belivablelevi/Lumi/README.md

# Lumi

**An open-source, build-it-yourself robot keychain pet.** A tiny glowing face
that feels your pats and shakes, has moods, sleeps when you put it down,
wakes when you pick it up, and plays ping-pong with a friend's
Lumi over the air.

Lumi is an independent DIY recreation of the *kind* of gadget popularised by
the Rekko NEO keychain. It's built from ~$15 of off-the-shelf modules. It
shares no code, artwork or branding with Rekko and isn't affiliated with it.

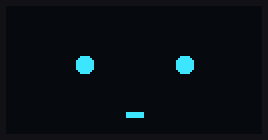
[picture p1: docs/previews/highlights.gif]
highlights


| Spec card item | Lumi |
|---|---|
| 0.96" OLED, 128×64, glowing cyan | SSD1306 0.96" 128×64 (blue panel reads as cyan) |
| Motion sensor, 6-axis, feels every pat & shake | MPU-6050: pat, double-pat, pat-spam, shake, drop, tilt, flip, pick-up, put-down |
| ESP32-C3 brain, runs 60+ animations | XIAO ESP32C3 · **64 animations** from 29 parametric expressions, plus blinking, eye-darts and breathing on top |
| 2-player wireless battle | **Tilt Pong** over ESP-NOW: classic Pong across two screens. Tilt to move your paddle, pat to smash, first to 5 |
| Battery inside | 702025 300 mAh LiPo (the case can be resized for others) |
| USB-C rechargeable | XIAO's USB-C + on-board charger |
| Deep-sleeps when idle | ESP32-C3 deep sleep, display off, IMU on wake-on-motion |
| Wakes when you pick it up | MPU-6050 motion interrupt → GPIO3 deep-sleep wake |
| Free animation updates | Wi-Fi update mode: phone → `192.168.4.1` → upload |
| 35 × 37 mm glitter shell | Parametric OpenSCAD snap-fit case, 35 × 37 × 25.5 mm, print in glitter PLA |

## What it looks like

All 29 expressions (rendered by the real firmware code in the simulator):

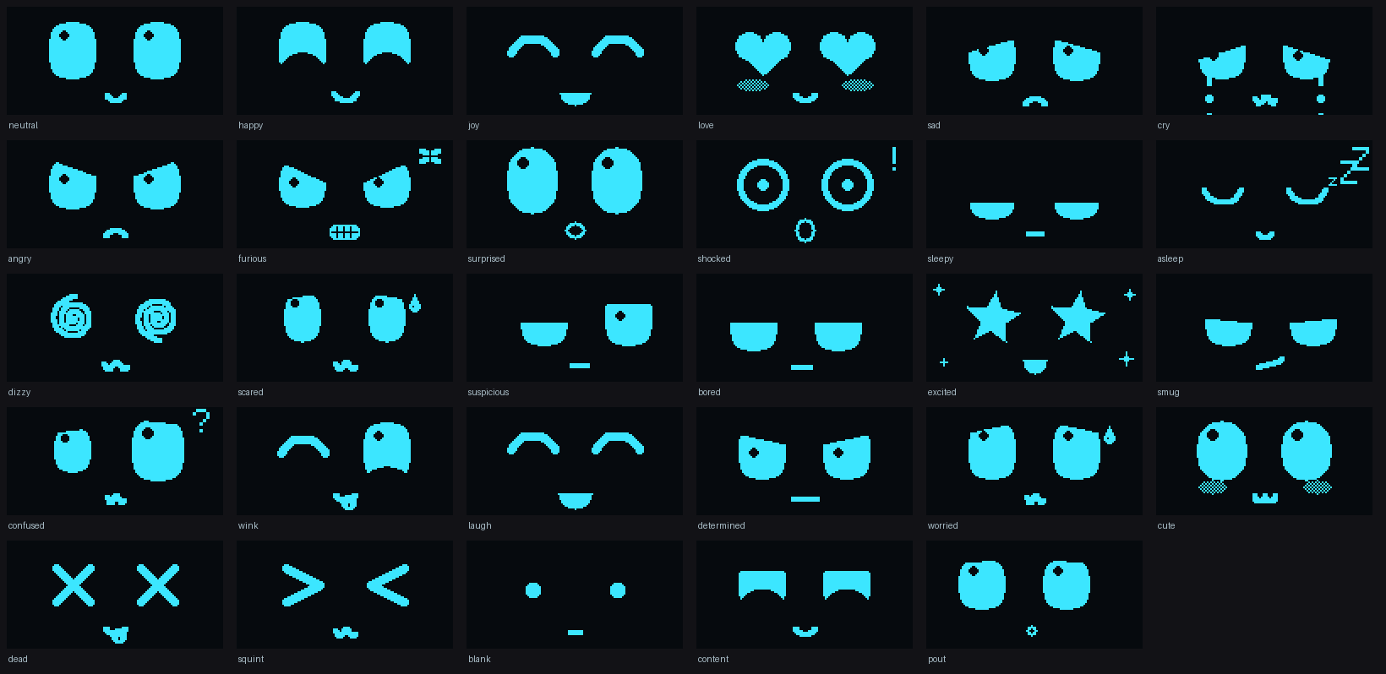
[picture p2: docs/previews/expressions.png]
expressions


Menu, battery, update and Tilt Pong screens:

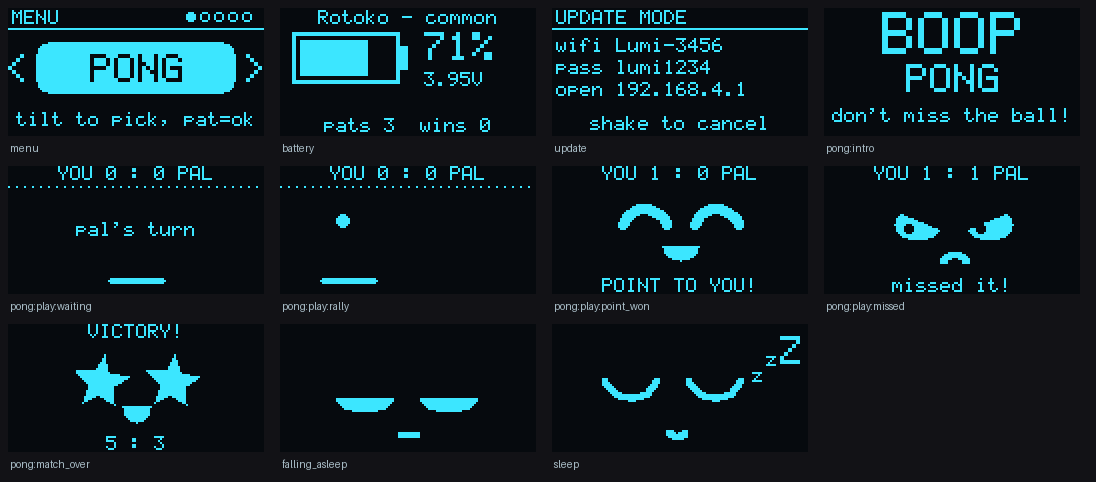
[picture p3: docs/previews/screens.png]
screens


A scripted session: boot, pats, shake, menu, a full Tilt Pong match, falling asleep
([tour.gif](docs/previews/tour.gif)).

## Every Lumi is one of a kind

Each unit has its own eyes, highlight, accent and temperament: 108,000
combinations, with common, uncommon, rare and legendary units. A unit gets
its personality automatically from its chip ID. Makers can also assign
one at the factory with **Lumi Studio**, a desktop app (Windows, macOS,
Linux) for:

- designing new faces and animations,
- generating batches of unique units with a rarity mix you choose,
- writing each unit's persona over USB and recording it in a manifest.

See [docs/studio.md](docs/studio.md).

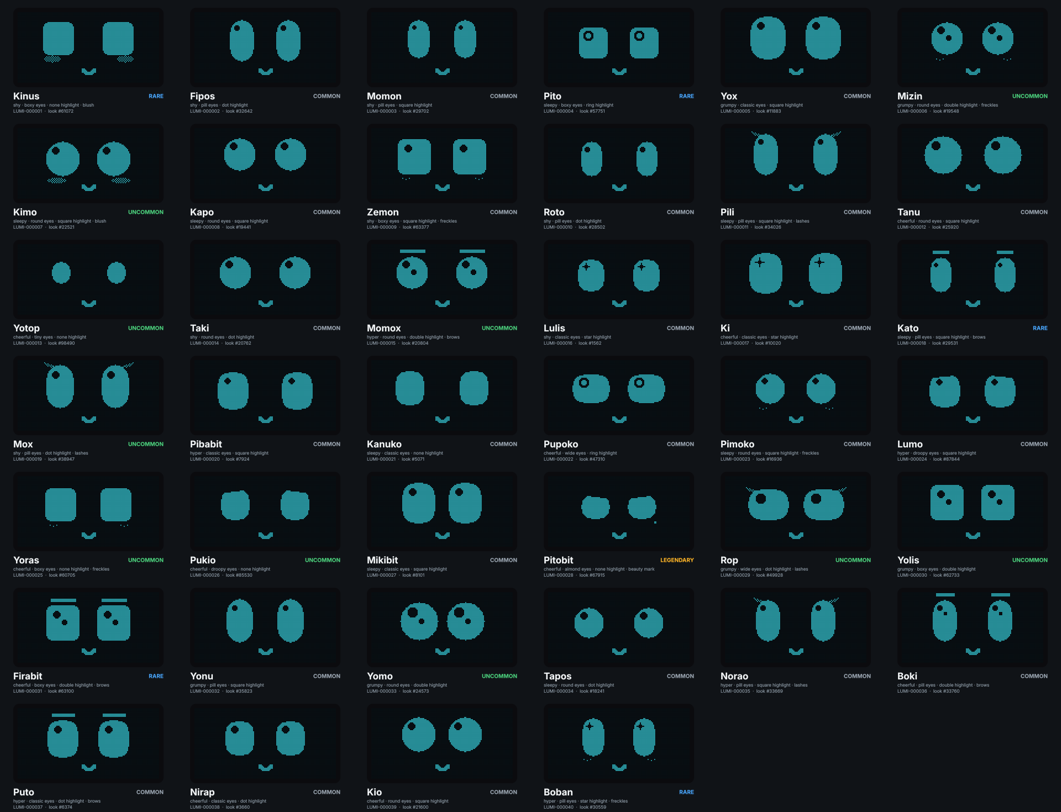
[picture p4: docs/previews/studio/cards-sheet.png]
units


## The website

`web/` is the Snaggo storefront for Lumi, at [snaggo.tech](https://snaggo.tech). It's a Next.js site with pre-orders through Stripe, launch emails, and the
firmware's real animations playing on every screen. See [web/README.md](web/README.md).

## Repository layout

```
firmware/
  platformio.ini            PlatformIO project (XIAO ESP32C3)
  src/                      hardware glue: main.cpp, OLED + IMU drivers, config.h (pins & tuning)
  lib/lumi_core/src/        portable brain, no Arduino dependencies:
    face.*                    parametric face renderer + 29 expressions
    animations.*              64 animations (data tables; add your own here or in Lumi Studio)
    genes.*                   per-unit looks, temperament and rarity
    pack.*                    emotion packs: custom faces, animations and a persona
    serial_cmd.*              USB provisioning protocol
    animator.*                tweening, blinking, eye darts, motion layers
    gestures.*                pat / shake / tilt / pickup / freefall detection
    mood.h                    happiness + energy, persisted across deep sleep
    pong.*                    Tilt Pong: pairing, ball hand-off over the radio, scoring
    app.*                     behaviour: modes, menu, sleep rules, screens
    gfx.*                     1-bit framebuffer + 5x7 font
hardware/
  BOM.md · wiring.md
  enclosure/lumi_case.scad  parametric case; stl/ has ready-to-print parts
docs/
  using-lumi.md             gestures, mood, menu, Tilt Pong, OTA, serial console
  assembly.md               build guide + first-power-up checklist
  studio.md                 Lumi Studio guide for makers
  previews/                 rendered images
tests/                      desktop tests for the core (make -C tests)
tools/
  sim/                      desktop simulator → PNG/GIF previews
  studio/                   Lumi Studio desktop app (PySide6) + liblumicore C API + virtual Lumi
web/                        the Snaggo website (Next.js storefront, pre-orders, launch signups)
  arduino_build.sh          build with arduino-cli / Arduino IDE instead of PlatformIO
```

## Build the firmware

**PlatformIO** (recommended):

```sh
cd firmware
pio run -t upload        # build + flash over USB-C
pio device monitor       # serial console (type 'h' for commands)
```

**arduino-cli / Arduino IDE** (ESP32 core 2.0.17):

```sh
tools/arduino_build.sh                # compile
tools/arduino_build.sh /dev/ttyACM0   # compile + upload
```

Using an **ESP32-S3 SuperMini** instead of the XIAO? Build with
`pio run -e esp32s3_supermini -t upload`, and see the S3 section of
[`hardware/wiring.md`](hardware/wiring.md#alternative-esp32-s3-supermini) for its
pins, power options and the matching case setting.

If the XIAO doesn't show up as a serial port, hold **BOOT**, tap **RESET**,
release **BOOT**, then upload again.

## Hack on it without hardware

The behaviour runs on your computer exactly as it does on the device:

```sh
make -C tests                         # 819 checks: gestures, pong, animations, genes, packs, app flows
python3 tools/sim/make_previews.py    # re-render docs/previews (needs Pillow)
python3 tools/sim/make_previews.py --all-gifs   # one GIF per animation in build/sim/gifs
```

Adding an animation is a few lines in `firmware/lib/lumi_core/src/animations.cpp`:
a list of `(expression, gaze, motion, tween ms, hold ms, effects)` keys
plus a table row saying which gesture triggers it and in which mood range.

## How it works (short version)

- **Face**: a face is ~20 numbers (eye size, lids, slant, cheeks, gaze, mouth
  shape…). Expressions are presets, and animations tween between them.
  Blinks, eye darts and breathing are layered on top, so Lumi never looks
  frozen.
- **Gestures**: the MPU-6050 samples at 100 Hz into its FIFO. The firmware
  high-passes the signal. Short sharp bursts are pats, repeated big bursts
  are shakes. Low-passed gravity gives orientation; |a| ≈ 0 is free-fall.
  Tap timestamps come from the FIFO cadence, so they stay accurate even
  while the display is being redrawn.
- **Tilt Pong**: ESP-NOW broadcast, no pairing. The Lumi with the higher
  MAC hosts and serves first. Tilt steers the paddle (low-passed gravity
  X). Only the Lumi the ball is on decides whether it was hit, so radio latency just makes the flight a little longer. Each
  ball crossing the net carries a sequence number plus its position, angle
  and speed, and each Lumi's miss count only ever grows. Packets repeat
  ~10 times a second, so lost ones only add delay. The tests play whole
  matches, and 90-second rallies, over a simulated link with 40% packet loss.
- **Sleep**: display charge pump off, IMU to low-power cycle mode with a
  latched motion interrupt on GPIO3, ESP32-C3 into deep sleep. Mood lives
  in RTC memory, and the RTC clock tells Lumi how long it slept.

## Status

- ✅ Core logic: 819 automated checks pass (ASan/UBSan clean), including
  two simulated Lumis playing complete Tilt Pong matches through their menus.
- ✅ Lumi Studio: 13 tests drive every tab offscreen and provision a virtual
  Lumi end to end. The packaged Linux app was built and started here. CI
  builds Windows and macOS too, but they haven't been tried by a person yet.
- ✅ Firmware compiles and links for the ESP32-C3 and ESP32-S3 (Arduino core
  2.0.17, `-Wall -Wextra`, no warnings in Lumi's code). On the C3 it uses
  812 KB of flash (63% of an OTA slot) and 87 KB of RAM.
- ✅ Case renders to valid STLs at 35 × 37 mm.
- ⚠️ **Not yet tested on real hardware.** Expect to tune the IMU axis map,
  tap threshold and wake sensitivity once it's built (see the checklist in
  `docs/assembly.md`), and to adjust case tolerances after a test print.
- ⚠️ The case is 25.5 mm deep because a stock GY-521 board won't fit beside
  the XIAO. A custom PCB, or a smaller IMU breakout, could get it thinner.

## License

MIT, see [LICENSE](LICENSE).
