belivablelevi/Lumi/hardware/filament.md

# Filament

## Test rolls

| Supplier | Order | Price (CAD) | Checked |
|---|---|---|---|
| [ELEGOO on Amazon.ca](https://www.amazon.ca/dp/B0DWJRNJTD) | 1 black and 1 grey PETG, 1.75 mm, 1 kg each (2-pack) | $33.29 (deal price, before tax) | November 2026 |

Use these to test case fit and the snap hooks in each colour. Buy more only after a case passes. Grey is the planned shell colour.

Print settings (Neptune 3 Pro, brass nozzle): 235-245 °C nozzle, 70-80 °C bed, 30-50% fan so the hook layers bond, glue stick or textured PEI. Dry the roll if it strings.

Plain PETG only. Carbon-fibre PETG is stiffer and more brittle, so the snap hooks are more likely to crack, and it wears out a brass nozzle.

## Compared

Filaments.ca: 1 black and 1 white Select PETG, 1 kg each, came to $45.18 ($29.98 + $10 shipping + tax).

Alibaba (Shenzhen Zhengtai Technology Co., Ltd.): the same two colours came to $53.69 CAD before tax ($11.86 rolls + $41.84 shipping), with delivery on Nov 17 at the earliest. Keep it as a possible sample order if a cheaper production supplier is needed later.
