belivablelevi/Lumi/hardware/pcb/BUDGET.md

# Lumi PCB v1: budget

Generated by [`budget.py`](budget.py) from prices checked on **2026-10-30**,
at **1 USD = 1.40 CAD**.

Prices move. Before you order:
- recheck everything against the JLCPCB quote page and LCSC,
- refresh lines marked *est.*, which come from similar listings rather than a live quote.

Edit the tables in `budget.py` and re-run it to update this page.

## At a glance

| | USD | CAD |
|---|--:|--:|
| 5 prototypes, all in | $190.02 | $266.03 |
| … per prototype | $38.00 | $53.21 |
| 10 prototypes, all in | $265.16 | $371.22 |
| … per prototype | $26.52 | $37.12 |
| One Lumi at 100 units | $11.22 | $15.70 |
| One Lumi at 1,000 units | $7.95 | $11.13 |
| **Average unit cost at 100 units** (packed, fees, spares, prototypes) | – | **$23.56** |
| **Average unit cost at 1,000 units** (packed, fees, spares, prototypes) | – | **$14.74** |

The device figures include:
- the board, built by JLCPCB,
- the screen, battery and printed case,
- shipping to Canada, GST and courier brokerage.

The average unit cost adds packaging, spares, the Stripe fee and the prototype run (see below).
Neither includes certification (until you enter a lab quote), customs duty beyond GST, or your time.

## 5 prototypes

| Item | USD | CAD |
|---|--:|--:|
| Board parts | $22.10 | $30.94 |
| Assembly (solder joints) | $2.01 | $2.82 |
| Bare boards (order of 5) | $4.00 | $5.60 |
| Assembly setup, stencil, 10 Extended-part fees | $43.00 | $60.20 |
| Screens | $12.45 | $17.43 |
| Batteries | $30.00 | $42.00 |
| Cases (printed) and sundries | $3.00 | $4.20 |
| Shipping: JLCPCB boards (DHL) | $25.00 | $35.00 |
| Shipping: Screens from BuyDisplay | $15.00 | $21.00 |
| Shipping: Batteries (AliExpress, ground) | $4.00 | $5.60 |
| GST 5% on imports | $8.03 | $11.24 |
| Courier brokerage (2 parcels) | $21.43 | $30.00 |
| **Total** | **$190.02** | **$266.03** |

## 10 prototypes

| Item | USD | CAD |
|---|--:|--:|
| Board parts | $44.20 | $61.88 |
| Assembly (solder joints) | $4.02 | $5.63 |
| Bare boards (order of 10) | $6.00 | $8.40 |
| Assembly setup, stencil, 10 Extended-part fees | $43.00 | $60.20 |
| Screens | $24.90 | $34.86 |
| Batteries | $60.00 | $84.00 |
| Cases (printed) and sundries | $6.00 | $8.40 |
| Shipping: JLCPCB boards (DHL) | $25.00 | $35.00 |
| Shipping: Screens from BuyDisplay | $15.00 | $21.00 |
| Shipping: Batteries (AliExpress, ground) | $4.00 | $5.60 |
| GST 5% on imports | $11.61 | $16.25 |
| Courier brokerage (2 parcels) | $21.43 | $30.00 |
| **Total** | **$265.16** | **$371.22** |

Notes on the prototype runs:
- **Fixed costs dominate:**
  - JLCPCB's setup, stencil and the 10 Extended-part fees ($3.00 each) come to $43.00 however many boards you build,
  - so does shipping.
  - That's why 10 boards cost far less than twice 5.
- **Extended-part fee:** one source says it dropped to $1.50 per part in December 2025. If your quote shows that, the run is about $12 cheaper.
- **Batteries:** buy them separately, by ground shipping. JLCPCB doesn't send lithium cells by air with boards.
- **Taxes:** courier parcels from China are taxed above CAD 20. HST provinces pay 13–15% instead of the 5% GST used here.

## Per Lumi at 100 units

| Item | USD | CAD |
|---|--:|--:|
| Board parts | $3.55 | $4.97 |
| Bare board | $0.25 | $0.35 |
| Assembly (joints) | $0.40 | $0.56 |
| Assembly setup and fees, shared | $0.60 | $0.84 |
| Screen | $2.23 | $3.12 |
| Battery | $2.50 | $3.50 |
| Case and sundries | $0.55 | $0.77 |
| Shipping share | $0.60 | $0.84 |
| GST 5% on imports | $0.53 | $0.75 |
| **Per unit** | **$11.22** | **$15.70** |

## Per Lumi at 1,000 units

| Item | USD | CAD |
|---|--:|--:|
| Board parts | $3.22 | $4.51 |
| Bare board | $0.08 | $0.11 |
| Assembly (joints) | $0.40 | $0.56 |
| Assembly setup and fees, shared | $0.06 | $0.08 |
| Screen | $1.70 | $2.38 |
| Battery | $1.40 | $1.96 |
| Case and sundries | $0.51 | $0.71 |
| Shipping share | $0.20 | $0.28 |
| GST 5% on imports | $0.38 | $0.53 |
| **Per unit** | **$7.95** | **$11.13** |

Notes on volume:
- **Setup:** assembly switches to Standard PCBA ($25 setup), shared across the run.
- **Biggest items:** the module and the screen are the two largest costs.
- **Screen:** at 1,000 the screen is an estimate for a factory-direct quote (the listing stops at $2.23 for 100).
- **Battery:** the 1,000 price assumes a factory quote with UN38.3 reports.
- **Case:** a home-printed case is cheap in plastic (~$0.45) but takes about 2.5 hours of printer time each. At 1,000, a print farm or an injection mould changes this line.

## Average unit cost (CAD)

From the device cost above to what each Lumi really costs: packed, with spares, the Stripe fee and the
prototype run spread over the batch. Packaging prices are estimates; edit `PACKAGING_CAD` (or the
**Full unit cost** tab in the workbook) with real quotes.

| Item | 100 units | 1,000 units |
|---|--:|--:|
| Device: board, screen, battery, case, import shipping, GST | $15.70 | $11.13 |
| Mailer box, 3 x 3 x 2 in | $0.60 | $0.35 |
| Padding (crinkle paper or foam) | $0.10 | $0.05 |
| Birth certificate (1/8 Letter sheet of card stock + ink) | $0.15 | $0.10 |
| Odds card (printed 4 x 6 postcard) | $0.40 | $0.12 |
| Shipping label | $0.10 | $0.05 |
| Spares and failed units (5% of the device) | $0.79 | $0.56 |
| **Cost to make and pack** | **$17.84** | **$12.36** |
| Stripe fee at a $59.00 price | $2.01 | $2.01 |
| Prototype run (10 boards) spread over the run | $3.71 | $0.37 |
| Certification (lab quote) spread over the run | $0.00 | $0.00 |
| One-time tools spread over the run | $0.00 | $0.00 |
| **Average unit cost** | **$23.56** | **$14.74** |
| Left from a $59.00 sale | $35.44 (60%) | $44.26 (75%) |

Notes:
- **Shipping** isn't here: the customer pays it at checkout. Stripe's fee on the shipping part (2.9%) is left out too.
- **Certification** is the big unknown: EMC testing of the finished Lumi (the radio module is already certified) often costs thousands. $2,000 adds $20 a unit at 100 and $2 at 1,000. Enter your lab quote in `CERT_CAD`.
- **Your time** (assembly, provisioning, testing, packing: maybe 10–15 minutes a unit) and **printer time** (about 2.5 h a case) aren't counted.
- The **price** ($59.00) is only an example, used for the Stripe fee and the margin line.

## Board parts by quantity (USD each)

| Ref | Part | LCSC | 5–10 boards | 100 | 1,000 |
|---|---|---|--:|--:|--:|
| U1 | ESP32-C3-MINI-1-H4X module | C41349510 | $2.72 | $2.26 | $2.16 |
| U2 | LIS2DH12TR accelerometer | C110926 | $0.78 | $0.58 | $0.53 |
| J2 | JUSHUO AFC07-S30ECC-00 screen connector | C11095 | $0.15 | $0.12 | $0.09 |
| D1 | USBLC6-2SC6 USB ESD | C7519 | $0.18 | $0.14 | $0.10 |
| J1 | USB-C receptacle TYPE-C-31-M-12 | C165948 | $0.19 | $0.15 | $0.10 |
| U4 | RT9080-33GJ5 3.3 V regulator | C841192 | $0.12 | $0.10 | $0.08 |
| U3 | TP4054 charger | C32574 | $0.13 | $0.10 | $0.08 |
| SW1 | MSK12C02 slide switch | C431540 | $0.05 | $0.04 | $0.04 |
| R/C | 28 resistors and capacitors (Basic except R8, R15) *est.* | various | $0.10 | $0.06 | $0.04 |

Board part prices are JLCPCB's parts library on 2026-11-05 (the 10, 100 and 1,000 price breaks).

> **Stock warning (2026-11-04):** JLCPCB and LCSC have **0** LIS2DH12TR (C110926) in stock. Before ordering boards, either wait for a restock, buy them elsewhere and send them to JLCPCB as consigned parts, or switch to an in-stock part with the same 2 × 2 mm LGA-12 package, such as the LIS2DW12TR (C189624, about $0.68 at 100). The LIS2DW12 has a different register map, so the firmware's accelerometer driver and the schematic would need checking first.
| Screen | BuyDisplay ER-OLED0.96-1 plug-in OLED (1,000: est. factory quote) | – | $2.49 | $2.23 | $1.70 |
| Battery | 503030 LiPo ~500 mAh, protected, UN38.3 (est.) | – | $6.00 | $2.50 | $1.40 |
| Case | Mini Lumi PCB case, PLA, ~17 g at $25/kg (your printer; ~2.5 h) | – | $0.45 | $0.45 | $0.45 |
| Sundries | foam tape, Kapton, battery wire (est.) | – | $0.15 | $0.10 | $0.06 |

## Sources

- [JLCPCB: what the PCB assembly price includes](https://jlcpcb.com/help/article/pcb-assembly-price)
- [JLCPCB PCBA price overview (feeder fee change)](https://techoverflow.net/2024/04/09/jlcpcb-pcba-assembly-price-overview/)
- [JLCPCB $2 PCB offer](https://jlcpcb.com/blog/free-assembly-for-1-6-layer-pcbs-and-discounts-on-8-20-layer-pcba)
- [ESP32-C3-MINI-1-H4X on JLCPCB](https://jlcpcb.com/partdetail/ESP32-C3-MINI-1-H4X/C41349510)
- [LIS2DH12TR on LCSC](https://www.lcsc.com/product-image/C110926.html)
- [TYPE-C-31-M-12 on LCSC](https://lcsc.com/product-detail/USB-Connectors_Korean-Hroparts-Elec-TYPE-C-31-M-12_C165948.html)
- [JUSHUO AFC07-S30ECC-00 on JLCPCB](https://jlcpcb.com/partdetail/C11095)
- [USBLC6-2SC6 on JLCPCB](https://jlcpcb.com/partdetail/C7519)
- [BuyDisplay ER-OLED0.96-1](https://buydisplay.com/blue-128x64-0-96-inch-oled-display-top-contact-connector-fpc-ssd1306)
- [503030 500 mAh protected LiPo (retail reference)](https://www.walmart.com/ip/seot/5362991161)
- [Shipping and brokerage to Canada (forum reports)](https://forum.kicad.info/t/alternatives-to-jlcpcb-or-pcbway-for-canadian-hobbyist/61624)
- [CBSA: courier imports from outside the US/Mexico (CAD 20 threshold)](https://www.cbsa-asfc.gc.ca/services/cusma-aceum/lvs-efv-eng.html)
- [USD/CAD, October 2026](https://moneyexchangerate.org/currencyexchange/usd/cad)
- [Stripe pricing, Canada](https://stripe.com/en-ca/pricing)
