belivablelevi/Lumi/docs/previews/tour.gif

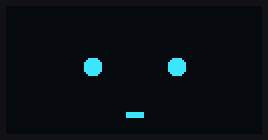
docs/previews/tour.gif
