belivablelevi/Lumi/hardware/pcb/kicad/renders/schematic.png

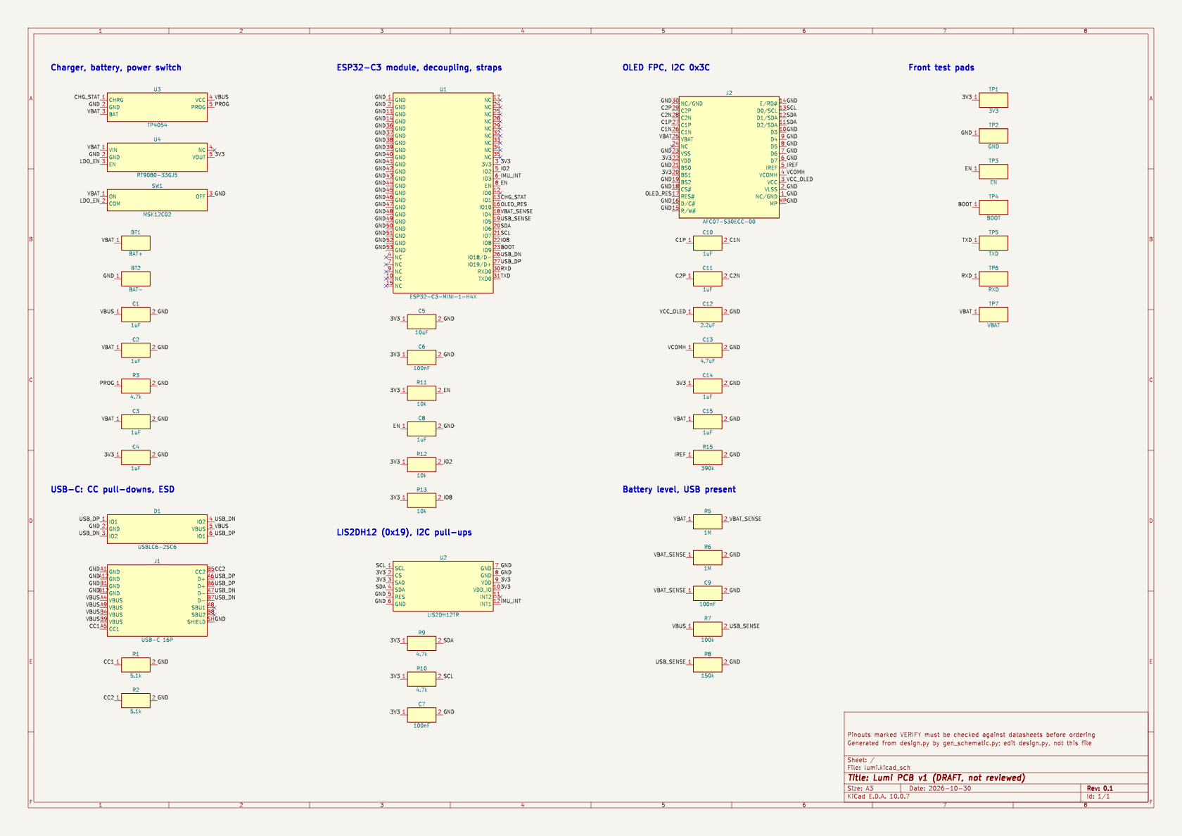
hardware/pcb/kicad/renders/schematic.png
