belivablelevi/Lumi/hardware/pcb/kicad/fab/parts-check.txt

Lumi PCB parts check, 2026-11-06
Generated by hardware/pcb/kicad/verify_parts.py against JLCPCB's parts library and LCSC's footprints. FIX = must change before ordering; note = worth knowing.

U1  ESP32-C3-MINI-1-H4X  C41349510  (lumi:ESP32-C3-MINI-1)
  ESP32-C3-MINI-1-H4X: Extended, JLCPCB stock 689, $3.1072 each
  -104dBm -40℃~+105℃ 2.4GHz 20.5dBm 350mA 3V~3.6V 82mA ESP32-C3FH4 Integrated Bluetooth function On-board PCB Antenna UART、SPI、I2C、GPIO、I2S、USB SMD,16.6x13.2mm WiFi Modules
  footprint: 61 pads line up (worst 0.000 mm) with LCSC's turned 0 degrees
  pins: names match LCSC's symbol

U2  LIS2DH12TR  C110926  (Package_LGA:LGA-12_2x2mm_P0.5mm)
  LIS2DH12TR: Extended, JLCPCB stock 9728, $0.9250 each
  -40℃~+85℃ 0.2KB 1.71V~3.6V 500nA 8bit、10bit、12bit Accelerometer Motion event detection SPI、I2C X,Y,Z ±16g LGA-12(2x2) Accelerometers
  footprint: 12 pads line up (worst 0.113 mm) with LCSC's turned 90 degrees
  pins: names match LCSC's symbol
  note: reviewed: KiCad's LGA-12 pads sit 0.11 mm further under the part than LCSC's. Both patterns are the same size and both overlap the LIS2DH12's 2 x 2 mm lands, so either solders; KiCad's stays inside the package outline. (12 pad differences)
  note: LCSC's footprint is turned 90 degrees from ours: JLCPCB's placement preview may show this part turned; turn it back to match the silkscreen

U3  TP4054  C32574  (Package_TO_SOT_SMD:SOT-23-5)
  TP4054-42-SOT25R: Extended, JLCPCB stock 74428, $0.1322 each
  -40℃~+85℃ 1 4.2V 450mA 45uA 4V~9V Charging IC Lithium Battery Not supported Not supported SOT-23-5 Battery Management
  footprint: 5 pads line up (worst 0.019 mm) with LCSC's turned 90 degrees
  pins: names match LCSC's symbol
  note: pad 1 is 1.32 x 0.60 mm, LCSC's 1.16 x 0.49
  note: pad 2 is 1.32 x 0.60 mm, LCSC's 1.16 x 0.49
  note: pad 3 is 1.32 x 0.60 mm, LCSC's 1.16 x 0.49
  note: LCSC's footprint is turned 90 degrees from ours: JLCPCB's placement preview may show this part turned; turn it back to match the silkscreen

U4  RT9080-33GJ5  C841192  (Package_TO_SOT_SMD:SOT-23-5)
  RT9080-33GJ5: Extended, JLCPCB stock 23633, $0.1197 each
  -40℃~+125℃@(Tj) 1 2uA 3.3V 360mV@(600mA) 42uVrms 5.5V 600mA 75dB@(1kHz) Fixed Over Current Protection、Over Temperature Protection、Enable Positive TSOT-23-5 Voltage Regulators - Linear, Low Drop Out (LDO) Regulators
  footprint: 5 pads line up (worst 0.012 mm) with LCSC's turned 90 degrees
  pins: names match LCSC's symbol
  note: pad 1 is 1.32 x 0.60 mm, LCSC's 1.05 x 0.53
  note: pad 2 is 1.32 x 0.60 mm, LCSC's 1.05 x 0.53
  note: pad 3 is 1.32 x 0.60 mm, LCSC's 1.05 x 0.53
  note: pad 4 is 1.32 x 0.60 mm, LCSC's 1.05 x 0.53
  note: pad 5 is 1.32 x 0.60 mm, LCSC's 1.05 x 0.53
  note: LCSC's footprint is turned 90 degrees from ours: JLCPCB's placement preview may show this part turned; turn it back to match the silkscreen

D1  USBLC6-2SC6  C7519  (Package_TO_SOT_SMD:SOT-23-6)
  USBLC6-2SC6: Extended, JLCPCB stock 26402, $0.1624 each
  -40℃~+125℃ 150nA 17V 2 3.5pF 5.25V 5A 6V ESD IEC 61000-4-2 Unidirectional SOT-23-6L ESD and Surge Protection (TVS/ESD)
  footprint: 6 pads line up (worst 0.012 mm) with LCSC's turned 90 degrees
  pins: LCSC's symbol has numbers only
  note: pad 1 is 1.32 x 0.60 mm, LCSC's 1.07 x 0.53
  note: pad 2 is 1.32 x 0.60 mm, LCSC's 1.07 x 0.53
  note: pad 3 is 1.32 x 0.60 mm, LCSC's 1.07 x 0.53
  note: pad 4 is 1.32 x 0.60 mm, LCSC's 1.07 x 0.53
  note: pad 5 is 1.32 x 0.60 mm, LCSC's 1.07 x 0.53
  note: pad 6 is 1.32 x 0.60 mm, LCSC's 1.07 x 0.53
  note: LCSC's footprint is turned 90 degrees from ours: JLCPCB's placement preview may show this part turned; turn it back to match the silkscreen

J1  USB-C 16P  C165948  (Connector_USB:USB_C_Receptacle_HRO_TYPE-C-31-M-12)
  TYPE-C-31-M-12: Extended, JLCPCB stock 146998, $0.1870 each
  -30℃~+80℃ 1 10,000 cycles 16P 20V 5A 7.35mm Female Surface Mount, Right Angle Type-C SMD USB Connectors
  footprint: 20 pads line up (worst 0.118 mm) with LCSC's turned 0 degrees
  pins: names match LCSC's symbol
  note: reviewed: Measured from the peg holes, KiCad's HRO footprint has the shell slots within 0.03 mm of LCSC's; its signal pads are centred 0.18 mm further out and 0.15 mm longer (1.45 vs 1.3 mm), so they still cover the leads. Its peg holes are 0.65 mm, LCSC's 0.6 mm. (6 pad differences)
  note: pad A1 is 0.06 mm from LCSC's (a slightly different land pattern)
  note: pad A4 is 0.06 mm from LCSC's (a slightly different land pattern)
  note: pad A4 is 0.60 x 1.45 mm, LCSC's 0.60 x 1.30
  note: pad A5 is 0.30 x 1.45 mm, LCSC's 0.30 x 1.30
  note: pad A6 is 0.30 x 1.45 mm, LCSC's 0.30 x 1.30
  note: pad A7 is 0.30 x 1.45 mm, LCSC's 0.30 x 1.30
  note: pad A8 is 0.30 x 1.45 mm, LCSC's 0.30 x 1.30
  note: pad A9 is 0.06 mm from LCSC's (a slightly different land pattern)
  note: pad A9 is 0.60 x 1.45 mm, LCSC's 0.60 x 1.30
  note: pad A12 is 0.06 mm from LCSC's (a slightly different land pattern)
  note: pad A12 is 0.60 x 1.45 mm, LCSC's 0.60 x 1.30
  note: pad B1 is 0.06 mm from LCSC's (a slightly different land pattern)
  note: pad B1 is 0.60 x 1.45 mm, LCSC's 0.60 x 1.30
  note: pad B4 is 0.06 mm from LCSC's (a slightly different land pattern)
  note: pad B4 is 0.60 x 1.45 mm, LCSC's 0.60 x 1.30
  note: pad B5 is 0.30 x 1.45 mm, LCSC's 0.30 x 1.30
  note: pad B6 is 0.30 x 1.45 mm, LCSC's 0.30 x 1.30
  note: pad B7 is 0.30 x 1.45 mm, LCSC's 0.30 x 1.30
  note: pad B8 is 0.30 x 1.45 mm, LCSC's 0.30 x 1.30
  note: pad B9 is 0.06 mm from LCSC's (a slightly different land pattern)
  note: pad B9 is 0.60 x 1.45 mm, LCSC's 0.60 x 1.30
  note: pad B12 is 0.06 mm from LCSC's (a slightly different land pattern)
  note: pad SH is 1.00 x 2.10 mm, LCSC's 1.20 x 2.00
  note: pad SH is 1.00 x 1.60 mm, LCSC's 1.20 x 1.80
  note: mounting/shield pads named differently (ours->LCSC): SH->4, SH->3, SH->1, SH->2
  note: origins 1.54 mm apart: JLCPCB's preview may show the part shifted by that much; nudge it onto its pads

J2  AFC07-S30ECC-00  C11095  (lumi:JUSHUO_AFC07-S30ECC-00)
  AFC07-S30ECC-00: Extended, JLCPCB stock 19465, $0.1549 each
  -25℃~+85℃ 0.3mm 0.5mm 2mm 30P 400mA 50V Phosphor bronze Slide Lock Surface Mount, Right Angle Tin Top Contact SMD,P=0.5mm,卧贴 FFC, FPC (Flat Flexible) Connector Assemblies
  footprint: 32 pads line up (worst 0.019 mm) with LCSC's turned 0 degrees
  pins: LCSC's symbol has numbers only
  note: pads numbered from the other end (our 1 = LCSC's 30); the pads themselves line up, which is what the factory places by
  note: mounting/shield pads named differently (ours->LCSC): MP->31, MP->32
  note: origins 0.45 mm apart: JLCPCB's preview may show the part shifted by that much; nudge it onto its pads

SW1  MSK12C02  C431540  (lumi:MSK12C02)
  MSK12C02: Extended, JLCPCB stock 180989, $0.0544 each
  -20℃~+70℃ 1.4mm 10000 times 12V 2.8mm 50mA 8mm SMD(SMT) Tab SPDT Surface Mount, Right Angle SMD,8x2.8mm Slide Switches
  footprint: 7 pads line up (worst 0.000 mm) with LCSC's turned 0 degrees
  pins: LCSC's symbol has numbers only

R1,R2  5.1k  C25905  (Resistor_SMD:R_0402_1005Metric)
  0402WGF5101TCE: Basic, JLCPCB stock 4687500, $0.0023 each
  -55℃~+155℃ 5.1kΩ 50V 62.5mW Thick Film Resistor ±1% ±100ppm/℃ 0402 Chip Resistor - Surface Mount
  value 5.1k matches
  footprint: 2 pads line up (worst 0.077 mm) with LCSC's turned 0 degrees
  pins: LCSC's symbol has numbers only
  note: pad 1 is 0.08 mm from LCSC's (a slightly different land pattern)
  note: pad 2 is 0.08 mm from LCSC's (a slightly different land pattern)

C1,C2,C3,C4,C8,C10,C11,C14,C15  1uF  C52923  (Capacitor_SMD:C_0402_1005Metric)
  CL05A105KA5NQNC: Basic, JLCPCB stock 11842566, $0.0058 each
  1uF 25V X5R ±10% 0402 Multilayer Ceramic Capacitors MLCC - SMD/SMT
  value 1uF matches
  footprint: 2 pads line up (worst 0.060 mm) with LCSC's turned 0 degrees
  pins: LCSC's symbol has numbers only
  note: pad 1 is 0.06 mm from LCSC's (a slightly different land pattern)
  note: pad 2 is 0.06 mm from LCSC's (a slightly different land pattern)

R3,R9,R10  4.7k  C25900  (Resistor_SMD:R_0402_1005Metric)
  0402WGF4701TCE: Basic, JLCPCB stock 16002473, $0.0017 each
  -55℃~+155℃ 4.7kΩ 50V 62.5mW Thick Film Resistor ±1% ±100ppm/℃ 0402 Chip Resistor - Surface Mount
  value 4.7k matches
  footprint: 2 pads line up (worst 0.077 mm) with LCSC's turned 0 degrees
  pins: LCSC's symbol has numbers only
  note: pad 1 is 0.08 mm from LCSC's (a slightly different land pattern)
  note: pad 2 is 0.08 mm from LCSC's (a slightly different land pattern)

C5  10uF  C15525  (Capacitor_SMD:C_0402_1005Metric)
  CL05A106MQ5NUNC: Basic, JLCPCB stock 9587627, $0.0258 each
  10uF 6.3V X5R ±20% 0402 Multilayer Ceramic Capacitors MLCC - SMD/SMT
  value 10uF matches
  footprint: 2 pads line up (worst 0.060 mm) with LCSC's turned 0 degrees
  pins: LCSC's symbol has numbers only
  note: pad 1 is 0.06 mm from LCSC's (a slightly different land pattern)
  note: pad 2 is 0.06 mm from LCSC's (a slightly different land pattern)

C6,C9,C7  100nF  C1525  (Capacitor_SMD:C_0402_1005Metric)
  CL05B104KO5NNNC: Basic, JLCPCB stock 34902490, $0.0031 each
  100nF 16V X7R ±10% 0402 Multilayer Ceramic Capacitors MLCC - SMD/SMT
  value 100nF matches
  footprint: 2 pads line up (worst 0.060 mm) with LCSC's turned 0 degrees
  pins: LCSC's symbol has numbers only
  note: pad 1 is 0.06 mm from LCSC's (a slightly different land pattern)
  note: pad 2 is 0.06 mm from LCSC's (a slightly different land pattern)

R11,R12,R13  10k  C25744  (Resistor_SMD:R_0402_1005Metric)
  0402WGF1002TCE: Basic, JLCPCB stock 16755165, $0.0028 each
  -55℃~+155℃ 10kΩ 50V 62.5mW Thick Film Resistor ±1% ±100ppm/℃ 0402 Chip Resistor - Surface Mount
  value 10k matches
  footprint: 2 pads line up (worst 0.077 mm) with LCSC's turned 0 degrees
  pins: LCSC's symbol has numbers only
  note: pad 1 is 0.08 mm from LCSC's (a slightly different land pattern)
  note: pad 2 is 0.08 mm from LCSC's (a slightly different land pattern)

R5,R6  1M  C26083  (Resistor_SMD:R_0402_1005Metric)
  0402WGF1004TCE: Basic, JLCPCB stock 2782071, $0.0015 each
  -55℃~+155℃ 1MΩ 50V 62.5mW Thick Film Resistor ±1% ±100ppm/℃ 0402 Chip Resistor - Surface Mount
  value 1M matches
  footprint: 2 pads line up (worst 0.077 mm) with LCSC's turned 0 degrees
  pins: LCSC's symbol has numbers only
  note: pad 1 is 0.08 mm from LCSC's (a slightly different land pattern)
  note: pad 2 is 0.08 mm from LCSC's (a slightly different land pattern)

R7  100k  C25741  (Resistor_SMD:R_0402_1005Metric)
  0402WGF1003TCE: Basic, JLCPCB stock 8292545, $0.0012 each
  -55℃~+155℃ 100kΩ 50V 62.5mW Thick Film Resistor ±1% ±100ppm/℃ 0402 Chip Resistor - Surface Mount
  value 100k matches
  footprint: 2 pads line up (worst 0.077 mm) with LCSC's turned 0 degrees
  pins: LCSC's symbol has numbers only
  note: pad 1 is 0.08 mm from LCSC's (a slightly different land pattern)
  note: pad 2 is 0.08 mm from LCSC's (a slightly different land pattern)

R8  150k  C25755  (Resistor_SMD:R_0402_1005Metric)
  0402WGF1503TCE: Extended, JLCPCB stock 1122371, $0.0011 each
  -55℃~+155℃ 150kΩ 50V 62.5mW Thick Film Resistor ±1% ±100ppm/℃ 0402 Chip Resistor - Surface Mount
  value 150k matches
  footprint: 2 pads line up (worst 0.077 mm) with LCSC's turned 0 degrees
  pins: LCSC's symbol has numbers only
  note: pad 1 is 0.08 mm from LCSC's (a slightly different land pattern)
  note: pad 2 is 0.08 mm from LCSC's (a slightly different land pattern)

C12  2.2uF  C23630  (Capacitor_SMD:C_0603_1608Metric)
  CL10A225KO8NNNC: Basic, JLCPCB stock 2378912, $0.0119 each
  16V 2.2uF X5R ±10% 0603 Multilayer Ceramic Capacitors MLCC - SMD/SMT
  value 2.2uF matches
  footprint: 2 pads line up (worst 0.075 mm) with LCSC's turned 0 degrees
  pins: LCSC's symbol has numbers only
  note: pad 1 is 0.07 mm from LCSC's (a slightly different land pattern)
  note: pad 2 is 0.07 mm from LCSC's (a slightly different land pattern)

C13  4.7uF  C19666  (Capacitor_SMD:C_0603_1608Metric)
  CL10A475KO8NNNC: Basic, JLCPCB stock 4006523, $0.0150 each
  16V 4.7uF X5R ±10% 0603 Multilayer Ceramic Capacitors MLCC - SMD/SMT
  value 4.7uF matches
  footprint: 2 pads line up (worst 0.075 mm) with LCSC's turned 0 degrees
  pins: LCSC's symbol has numbers only
  note: pad 1 is 0.07 mm from LCSC's (a slightly different land pattern)
  note: pad 2 is 0.07 mm from LCSC's (a slightly different land pattern)

R15  390k  C25782  (Resistor_SMD:R_0402_1005Metric)
  0402WGF3903TCE: Extended, JLCPCB stock 804063, $0.0011 each
  -55℃~+155℃ 390kΩ 50V 62.5mW Thick Film Resistor ±1% ±100ppm/℃ 0402 Chip Resistor - Surface Mount
  value 390k matches
  footprint: 2 pads line up (worst 0.077 mm) with LCSC's turned 0 degrees
  pins: LCSC's symbol has numbers only
  note: pad 1 is 0.08 mm from LCSC's (a slightly different land pattern)
  note: pad 2 is 0.08 mm from LCSC's (a slightly different land pattern)

Extended part types (10, each adds JLCPCB's loading fee per order): U1; U2; U3; U4; D1; J1; J2; SW1; R8; R15
Nothing to fix.
