belivablelevi/Lumi/hardware/pcb/kicad/fab/lumi-bom.csv

Comment | Designator | Footprint | LCSC Part #
1uF | C1,C2,C3,C4,C8,C10,C11,C14,C15 | C_0402_1005Metric | C52923
2.2uF | C12 | C_0603_1608Metric | C23630
4.7uF | C13 | C_0603_1608Metric | C19666
10uF | C5 | C_0402_1005Metric | C15525
100nF | C6,C7,C9 | C_0402_1005Metric | C1525
USBLC6-2SC6 | D1 | SOT-23-6 | C7519
USB-C 16P | J1 | USB_C_Receptacle_HRO_TYPE-C-31-M-12 | C165948
AFC07-S30ECC-00 | J2 | JUSHUO_AFC07-S30ECC-00 | C11095
5.1k | R1,R2 | R_0402_1005Metric | C25905
10k | R11,R12,R13 | R_0402_1005Metric | C25744
390k | R15 | R_0402_1005Metric | C25782
4.7k | R3,R9,R10 | R_0402_1005Metric | C25900
1M | R5,R6 | R_0402_1005Metric | C26083
100k | R7 | R_0402_1005Metric | C25741
150k | R8 | R_0402_1005Metric | C25755
MSK12C02 | SW1 | MSK12C02 | C431540
ESP32-C3-MINI-1-H4X | U1 | ESP32-C3-MINI-1 | C41349510
LIS2DH12TR | U2 | LGA-12_2x2mm_P0.5mm | C110926
TP4054 | U3 | SOT-23-5 | C32574
RT9080-33GJ5 | U4 | SOT-23-5 | C841192
