belivablelevi/Lumi/hardware/pcb/budget.csv

section | item | usd | cad
5 prototypes | Board parts | 22.10 | 30.94
5 prototypes | Assembly (solder joints) | 2.01 | 2.82
5 prototypes | Bare boards (order of 5) | 4.00 | 5.60
5 prototypes | Assembly setup, stencil, 10 Extended-part fees | 43.00 | 60.20
5 prototypes | Screens | 12.45 | 17.43
5 prototypes | Batteries | 30.00 | 42.00
5 prototypes | Cases (printed) and sundries | 3.00 | 4.20
5 prototypes | Shipping: JLCPCB boards (DHL) | 25.00 | 35.00
5 prototypes | Shipping: Screens from BuyDisplay | 15.00 | 21.00
5 prototypes | Shipping: Batteries (AliExpress, ground) | 4.00 | 5.60
5 prototypes | GST 5% on imports | 8.03 | 11.24
5 prototypes | Courier brokerage (2 parcels) | 21.43 | 30.00
5 prototypes | TOTAL | 190.02 | 266.03
10 prototypes | Board parts | 44.20 | 61.88
10 prototypes | Assembly (solder joints) | 4.02 | 5.63
10 prototypes | Bare boards (order of 10) | 6.00 | 8.40
10 prototypes | Assembly setup, stencil, 10 Extended-part fees | 43.00 | 60.20
10 prototypes | Screens | 24.90 | 34.86
10 prototypes | Batteries | 60.00 | 84.00
10 prototypes | Cases (printed) and sundries | 6.00 | 8.40
10 prototypes | Shipping: JLCPCB boards (DHL) | 25.00 | 35.00
10 prototypes | Shipping: Screens from BuyDisplay | 15.00 | 21.00
10 prototypes | Shipping: Batteries (AliExpress, ground) | 4.00 | 5.60
10 prototypes | GST 5% on imports | 11.61 | 16.25
10 prototypes | Courier brokerage (2 parcels) | 21.43 | 30.00
10 prototypes | TOTAL | 265.16 | 371.22
per unit at 100 | Board parts | 3.55 | 4.97
per unit at 100 | Bare board | 0.25 | 0.35
per unit at 100 | Assembly (joints) | 0.40 | 0.56
per unit at 100 | Assembly setup and fees, shared | 0.60 | 0.84
per unit at 100 | Screen | 2.23 | 3.12
per unit at 100 | Battery | 2.50 | 3.50
per unit at 100 | Case and sundries | 0.55 | 0.77
per unit at 100 | Shipping share | 0.60 | 0.84
per unit at 100 | GST 5% on imports | 0.53 | 0.75
per unit at 100 | TOTAL | 11.22 | 15.70
per unit at 1000 | Board parts | 3.22 | 4.51
per unit at 1000 | Bare board | 0.08 | 0.11
per unit at 1000 | Assembly (joints) | 0.40 | 0.56
per unit at 1000 | Assembly setup and fees, shared | 0.06 | 0.08
per unit at 1000 | Screen | 1.70 | 2.38
per unit at 1000 | Battery | 1.40 | 1.96
per unit at 1000 | Case and sundries | 0.51 | 0.71
per unit at 1000 | Shipping share | 0.20 | 0.28
per unit at 1000 | GST 5% on imports | 0.38 | 0.53
per unit at 1000 | TOTAL | 7.95 | 11.13
average unit cost at 100 | Device: board, screen, battery, case, import shipping, GST | 11.22 | 15.70
average unit cost at 100 | Mailer box, 3 x 3 x 2 in | 0.43 | 0.60
average unit cost at 100 | Padding (crinkle paper or foam) | 0.07 | 0.10
average unit cost at 100 | Birth certificate (1/8 Letter sheet of card stock + ink) | 0.11 | 0.15
average unit cost at 100 | Odds card (printed 4 x 6 postcard) | 0.29 | 0.40
average unit cost at 100 | Shipping label | 0.07 | 0.10
average unit cost at 100 | Spares and failed units (5% of the device) | 0.56 | 0.79
average unit cost at 100 | Cost to make and pack | 12.74 | 17.84
average unit cost at 100 | Stripe fee at a $59.00 price | 1.44 | 2.01
average unit cost at 100 | Prototype run (10 boards) spread over the run | 2.65 | 3.71
average unit cost at 100 | Certification (lab quote) spread over the run | 0.00 | 0.00
average unit cost at 100 | One-time tools spread over the run | 0.00 | 0.00
average unit cost at 100 | TOTAL | 16.83 | 23.56
average unit cost at 1000 | Device: board, screen, battery, case, import shipping, GST | 7.95 | 11.13
average unit cost at 1000 | Mailer box, 3 x 3 x 2 in | 0.25 | 0.35
average unit cost at 1000 | Padding (crinkle paper or foam) | 0.04 | 0.05
average unit cost at 1000 | Birth certificate (1/8 Letter sheet of card stock + ink) | 0.07 | 0.10
average unit cost at 1000 | Odds card (printed 4 x 6 postcard) | 0.09 | 0.12
average unit cost at 1000 | Shipping label | 0.04 | 0.05
average unit cost at 1000 | Spares and failed units (5% of the device) | 0.40 | 0.56
average unit cost at 1000 | Cost to make and pack | 8.83 | 12.36
average unit cost at 1000 | Stripe fee at a $59.00 price | 1.44 | 2.01
average unit cost at 1000 | Prototype run (10 boards) spread over the run | 0.27 | 0.37
average unit cost at 1000 | Certification (lab quote) spread over the run | 0.00 | 0.00
average unit cost at 1000 | One-time tools spread over the run | 0.00 | 0.00
average unit cost at 1000 | TOTAL | 10.53 | 14.74
