belivablelevi/Lumi/hardware/pcb/budget.xlsx

Sheet: Summary
Lumi PCB v1: budget
Prices checked 2026-10-30. Change inputs on the Inputs and Parts tabs; everything here updates.
 | USD | CAD
Prototype run A, all in
... per prototype
Prototype run B, all in
... per prototype
One Lumi in a 100 run
One Lumi in a 1,000 run
Average unit cost, 100 run
Average unit cost, 1,000 run
Run A boards
Run B boards
Exchange rate (CAD per USD)
GST on imports
Colour key
Blue text: an input you can change
Black text: a formula
Green text: a value pulled from another tab
Yellow fill: key assumption
One Lumi: board built by JLCPCB, screen, battery, printed case, shipping to Canada, GST
and courier brokerage. Average unit cost adds packaging, spares, Stripe's fee and the
prototype run. Excludes certification (until a quote is entered on Inputs) and your time.

Sheet: Inputs
Inputs: edit the blue cells
Prices in USD, checked 2026-10-30. Yellow = key assumptions.
Assumption | Value | Note
Exchange rate (CAD per 1 USD) | 1.40 | About 1.40-1.43 through October 2026 (moneyexchangerate.org).
GST on imports | 5.0% | Federal GST. HST provinces pay 13-15% instead: change this.
Courier brokerage per parcel (CAD) | $15.00 | Forum reports of DHL/UPS clearance fees for Canada.
Courier parcels per prototype run | 2 | JLCPCB boards + screens; batteries come by ground post.
JLCPCB assembly
Economic assembly setup (per order) | $8.00 | JLCPCB help: PCB assembly price.
Stencil (per order) | $1.50 | JLCPCB help: PCB assembly price.
Extended part types on the board | 10 | U1-U4, D1, J1, J2, SW1, and the 150k (R8) and 390k (R15) resistors, which have no Basic part.
Fee per Extended part type | $3.00 | Official FAQ says $3; one source says $1.50 since Dec 2025.
Hand-soldering setup (USB-C shell legs) | $3.50 | JLCPCB help.
Standard assembly setup (100+ runs) | $25.00 | JLCPCB help (older price page).
SMT solder joints per board | 196 | Counted from the board's pads (approx.).
Cost per SMT joint | $0.0017 | JLCPCB Economic assembly.
Hand-soldered joints per board | 4 | USB-C shell legs.
Cost per hand-soldered joint | $0.0173 | JLCPCB help.
Bare boards (31 x 33 mm, 2 layers, 1.0 mm)
Order of 5 boards | $4.00 | Estimate; $2 offer is for 1.6 mm boards.
Order of 10 boards | $6.00 | Estimate.
Per board at 100 | $0.25 | Estimate.
Per board at 1,000 | $0.08 | Estimate.
Shipping
JLCPCB boards to Canada (DHL) | $25.00 | Forum reports: ~$17-25 for small orders.
Screens from BuyDisplay | $15.00 | Estimate.
Batteries (AliExpress, ground) | $4.00 | Estimate.
Shipping share per unit at 100 | $0.60 | Estimate (air freight).
Shipping share per unit at 1,000 | $0.20 | Estimate (air freight).
Selling and one-time costs (CAD)
Example selling price (CAD) | $59.00 | Only used for the Stripe fee and the margin on the Full unit cost tab.
Stripe fee, percent of the sale | 2.9% | Stripe Canada, domestic cards (stripe.com/en-ca/pricing).
Stripe fee, fixed per order (CAD) | $0.30 | Stripe Canada.
Spares and failed units (share of device cost) | 5.0% | Planning allowance for parts that fail testing or get damaged.
Certification lab quote (CAD) | $0.00 | EMC testing of the finished Lumi (ICES-003 / FCC Part 15B). Enter your quote; often thousands.
One-time tools (CAD) | $0.00 | Paper trimmer, calipers, corner punch...

Sheet: Parts
Parts: price each (USD) by how many you buy
Blue = edit. Prices from LCSC/JLCPCB listings; 'Yes' in Estimate = no live quote seen.
Ref | Part | LCSC | 5-10 boards | 100 | 1,000 | Estimate? | Note
U1 | ESP32-C3-MINI-1-H4X module | C41349510 | $2.72 | $2.26 | $2.16 | No
U2 | LIS2DH12TR accelerometer | C110926 | $0.78 | $0.58 | $0.53 | No
J2 | JUSHUO AFC07-S30ECC-00 screen connector | C11095 | $0.15 | $0.12 | $0.09 | No
D1 | USBLC6-2SC6 USB ESD | C7519 | $0.18 | $0.14 | $0.10 | No
J1 | USB-C receptacle TYPE-C-31-M-12 | C165948 | $0.19 | $0.15 | $0.10 | No
U4 | RT9080-33GJ5 3.3 V regulator | C841192 | $0.12 | $0.10 | $0.08 | No
U3 | TP4054 charger | C32574 | $0.13 | $0.10 | $0.08 | No
SW1 | MSK12C02 slide switch | C431540 | $0.05 | $0.04 | $0.04 | No
R/C | 28 resistors and capacitors (Basic except R8, R15) | various | $0.10 | $0.06 | $0.04 | Yes
 | Board parts, per board
Item | Part |  | 5-10 units | 100 | 1,000 |  | Note
Screen | BuyDisplay ER-OLED0.96-1 plug-in OLED |  | $2.49 | $2.23 | $1.70 |  | 1,000: est. factory quote
Battery | 503030 LiPo ~500 mAh, protected, UN38.3 |  | $6.00 | $2.50 | $1.40 |  | est.
Case | Mini Lumi PCB case, PLA, ~17 g at $25/kg |  | $0.45 | $0.45 | $0.45 |  | your printer; ~2.5 h
Sundries | foam tape, Kapton, battery wire |  | $0.15 | $0.10 | $0.06 |  | est.

Sheet: Prototypes
Prototype runs, all in
Edit the quantities in row 4 (blue). Bare-board order prices are on Inputs.
 | Run A (USD) | Run A (CAD) | Run B (USD) | Run B (CAD)
Boards in the run | 5 |  | 10
Board parts
Assembly (solder joints)
Bare boards (one order)
Assembly setup, stencil, Extended-part fees
Screens
Batteries
Cases (printed) and sundries
Shipping: JLCPCB boards (DHL)
Shipping: screens
Shipping: batteries
GST on imports
Courier brokerage
Total
Per prototype
Fixed costs (setup, stencil, Extended-part fees, shipping) are the same for any run size, which is why 10 boards cost far less than twice 5.

Sheet: Per unit
Cost of one Lumi at volume
Uses the 100 and 1,000 price columns on Parts. Edit run sizes in row 4.
 | 100 run (USD) | 100 run (CAD) | 1,000 run (USD) | 1,000 run (CAD)
Units in the run | 100 |  | 1000
Board parts
Bare board
Assembly (solder joints)
Assembly setup and fees, shared
Screen
Battery
Case and sundries
Shipping share
GST on imports
Per unit
Whole run

Sheet: Full unit cost
Average unit cost (CAD)
The device cost, packed, plus spares, the Stripe fee and one-time costs spread over the run. Blue = edit (packaging here; price, fees and quotes on Inputs).
 | 100 run (CAD) | 1,000 run (CAD) | Note
Units in the run |  |  | Set on the Per unit tab.
Device: board, screen, battery, case, import shipping, GST |  |  | From the Per unit tab.
Mailer box, 3 x 3 x 2 in | $0.60 | $0.35 | Estimate; Uline.ca / Amazon packs.
Padding (crinkle paper or foam) | $0.10 | $0.05 | Estimate; est..
Birth certificate (1/8 Letter sheet of card stock + ink) | $0.15 | $0.10 | Estimate; home or Staples printing.
Odds card (printed 4 x 6 postcard) | $0.40 | $0.12 | Estimate; Vistaprint / Staples run.
Shipping label | $0.10 | $0.05 | Estimate; 4 x 6 label sheets.
Spares and failed units |  |  | Share set on Inputs.
Cost to make and pack
Stripe fee on the selling price |  |  | Stripe also takes 2.9% of the shipping the customer pays; not counted.
Prototype run B spread over the run |  |  | The 10-board run's total, from the Prototypes tab.
Certification spread over the run |  |  | Lab quote on Inputs.
One-time tools spread over the run |  |  | On Inputs.
Average unit cost
Selling price
Left from each sale
Margin
Shipping isn't here: the customer pays it at checkout. Your time (assembly, testing, packing) and printer time aren't counted.

Sheet: Sources
Sources
What | Link
JLCPCB: what the PCB assembly price includes | https://jlcpcb.com/help/article/pcb-assembly-price
JLCPCB PCBA price overview (feeder fee change) | https://techoverflow.net/2024/04/09/jlcpcb-pcba-assembly-price-overview/
JLCPCB $2 PCB offer | https://jlcpcb.com/blog/free-assembly-for-1-6-layer-pcbs-and-discounts-on-8-20-layer-pcba
ESP32-C3-MINI-1-H4X on JLCPCB | https://jlcpcb.com/partdetail/ESP32-C3-MINI-1-H4X/C41349510
LIS2DH12TR on LCSC | https://www.lcsc.com/product-image/C110926.html
TYPE-C-31-M-12 on LCSC | https://lcsc.com/product-detail/USB-Connectors_Korean-Hroparts-Elec-TYPE-C-31-M-12_C165948.html
JUSHUO AFC07-S30ECC-00 on JLCPCB | https://jlcpcb.com/partdetail/C11095
USBLC6-2SC6 on JLCPCB | https://jlcpcb.com/partdetail/C7519
BuyDisplay ER-OLED0.96-1 | https://buydisplay.com/blue-128x64-0-96-inch-oled-display-top-contact-connector-fpc-ssd1306
503030 500 mAh protected LiPo (retail reference) | https://www.walmart.com/ip/seot/5362991161
Shipping and brokerage to Canada (forum reports) | https://forum.kicad.info/t/alternatives-to-jlcpcb-or-pcbway-for-canadian-hobbyist/61624
CBSA: courier imports from outside the US/Mexico (CAD 20 threshold) | https://www.cbsa-asfc.gc.ca/services/cusma-aceum/lvs-efv-eng.html
USD/CAD, October 2026 | https://moneyexchangerate.org/currencyexchange/usd/cad
Stripe pricing, Canada | https://stripe.com/en-ca/pricing
