belivablelevi/Lumi/hardware/enclosure/alternatives/mini_lumi2/mini_lumi2.stl

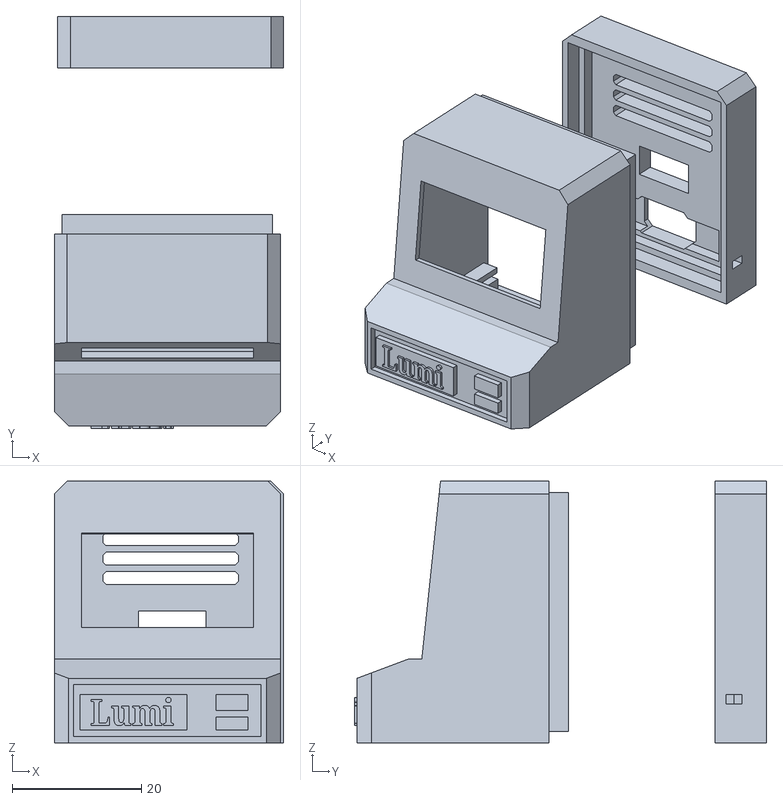
[picture p19: CAD file, 2026-10-30]
hardware/enclosure/alternatives/mini_lumi2/mini_lumi2.stl
35.5 x 63.7 x 40.5
