belivablelevi/Lumi/hardware/enclosure/blender/lumi_pcb_v1_refs.obj

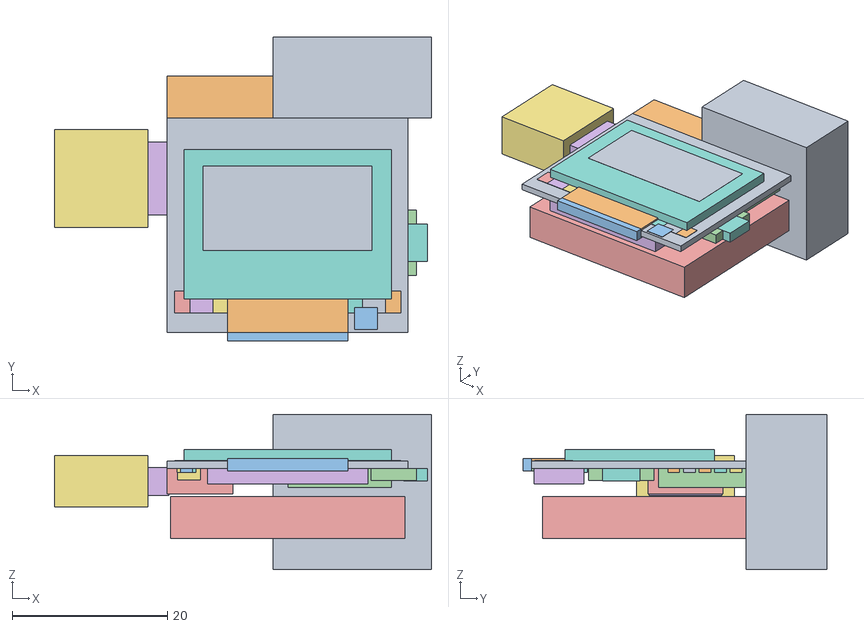
[picture p20: CAD file, 2026-11-06]
hardware/enclosure/blender/lumi_pcb_v1_refs.obj
48.5 x 39.1 x 20.0
PCB
PCB,_corner_beside_the_antenna
BT1_BAT+
BT2_BAT-
C1_1uF
C10_1uF
C11_1uF
C12_2.2uF
C13_4.7uF
C14_1uF
C15_1uF
C2_1uF
C3_1uF
C4_1uF
C5_10uF
C6_100nF
C7_100nF
C8_1uF
C9_100nF
D1_USBLC6-2SC6
J1_USB-C_16P
J2_AFC07-S30ECC-00
R1_5.1k
R10_4.7k
R11_10k
R12_10k
R13_10k
R15_390k
R2_5.1k
R3_4.7k
R5_1M
R6_1M
R7_100k
R8_150k
R9_4.7k
SW1_MSK12C02
TP1_3V3
TP2_GND
TP3_EN
TP4_BOOT
TP5_TXD
TP6_RXD
TP7_VBAT
U1_ESP32-C3-MINI-1-H4X
U2_LIS2DH12TR
U3_TP4054
U4_RT9080-33GJ5
OLED_glass
OLED_active_area
OLED_cable,_front_run
OLED_cable,_bend
OLED_cable,_back_run
Battery_503030
USB-C_opening
USB-C_plug_clearance
Switch_lever_slot
Antenna_keep-out
