belivablelevi/Lumi/hardware/enclosure/stl/lumi_front_s3.stl

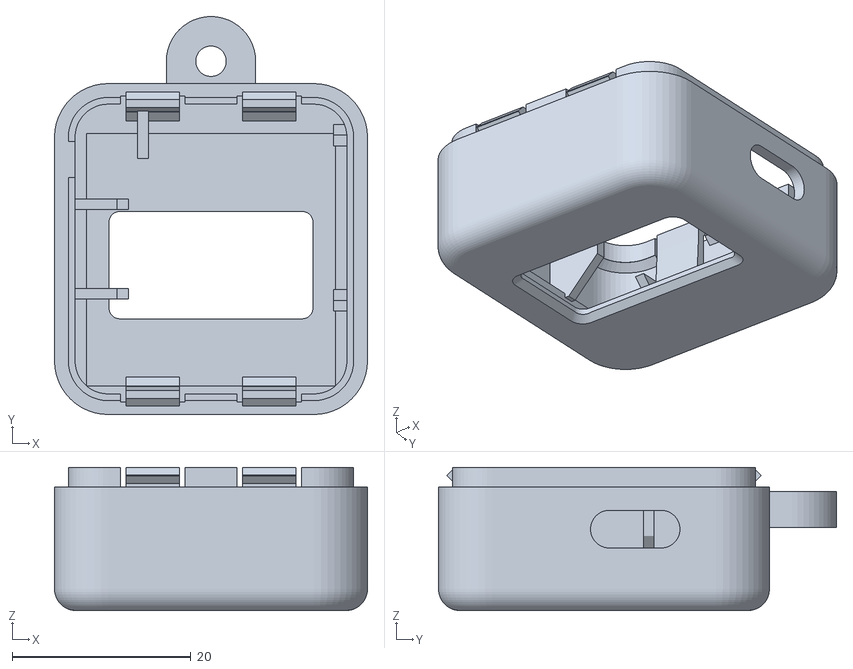
[picture p21: CAD file, 2026-11-04]
hardware/enclosure/stl/lumi_front_s3.stl
35.0 x 44.5 x 16.0
