belivablelevi/Lumi/hardware/pcb/kicad/fab/lumi.step

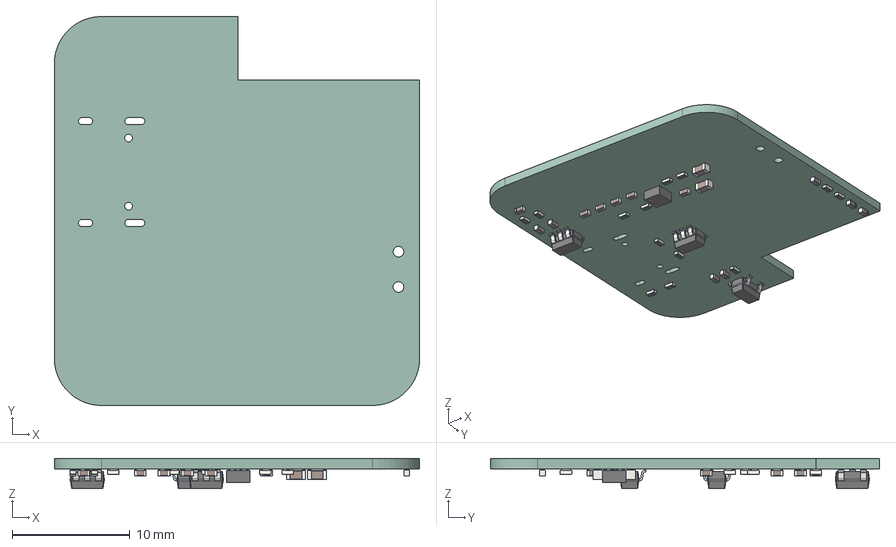
[picture p22: CAD file, 2026-11-06]
hardware/pcb/kicad/fab/lumi.step
31.0 x 33.0 x 2.55 mm
C_0402_1005Metric x 13
SOT-23-6
R_0402_1005Metric x 13
C_0603_1608Metric x 2
SOT-23-5 x 2
LGA_12_2x2mm_P05mm
lumi_PCB
