belivablelevi/Lumi/web/public/models/lumi-body.stl

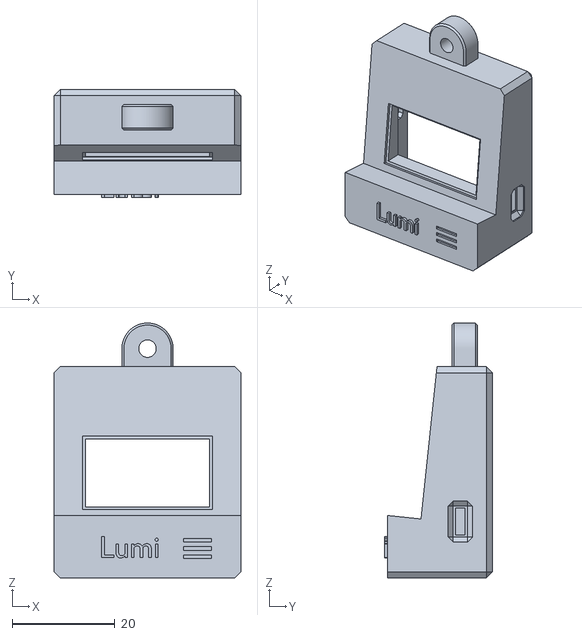
[picture p23: CAD file, 2026-11-03]
web/public/models/lumi-body.stl
36.4 x 21.0 x 49.7
