belivablelevi/Lumi/hardware/enclosure/stl/lumi_back.stl

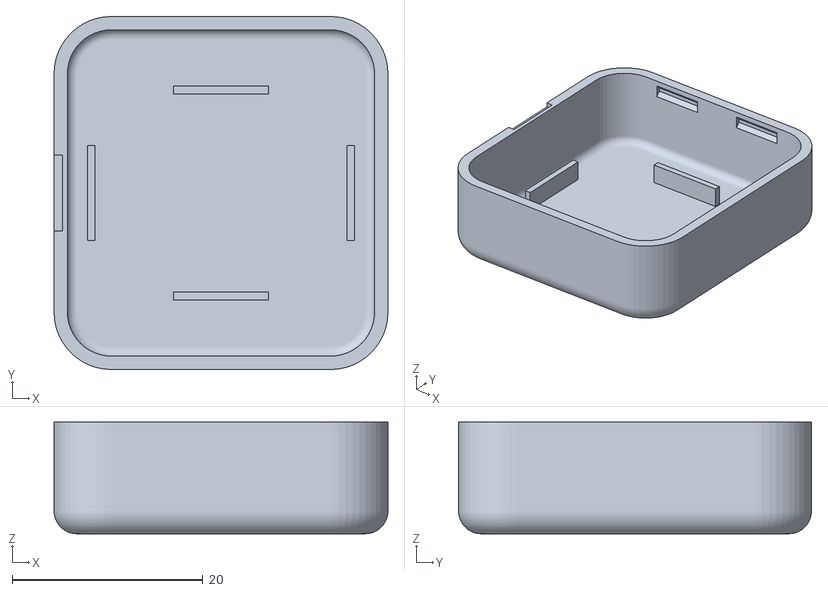
[picture p24: CAD file, 2026-11-04]
hardware/enclosure/stl/lumi_back.stl
35.0 x 37.0 x 11.7
