belivablelevi/Lumi/web/public/models/lumi-lid.stl

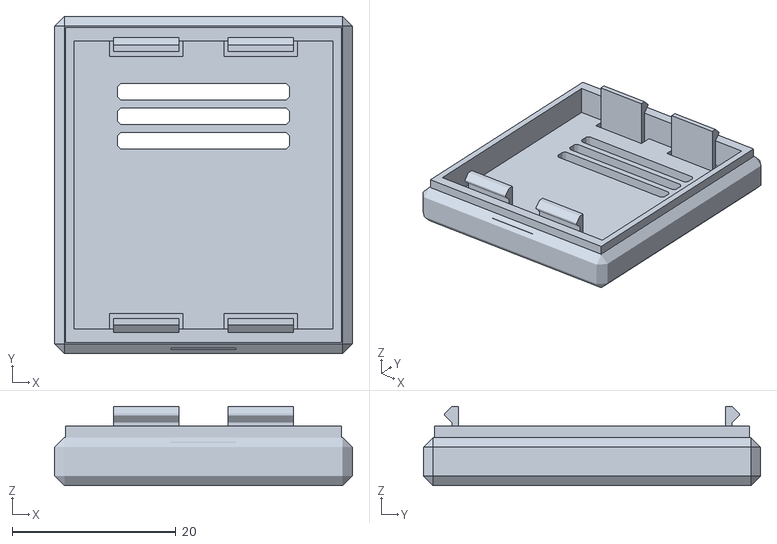
[picture p25: CAD file, 2026-11-03]
web/public/models/lumi-lid.stl
36.4 x 41.2 x 9.70
