belivablelevi/Lumi/hardware/enclosure/stl/snap_test.stl

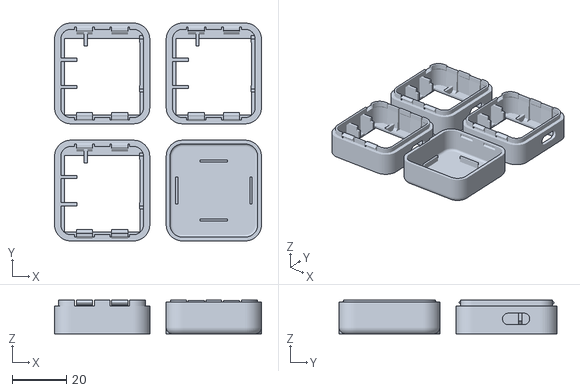
[picture p26: CAD file, 2026-11-04]
hardware/enclosure/stl/snap_test.stl
76.0 x 80.0 x 12.4
