belivablelevi/Lumi/hardware/enclosure/stl/lumi_front_s3_tp4056.stl

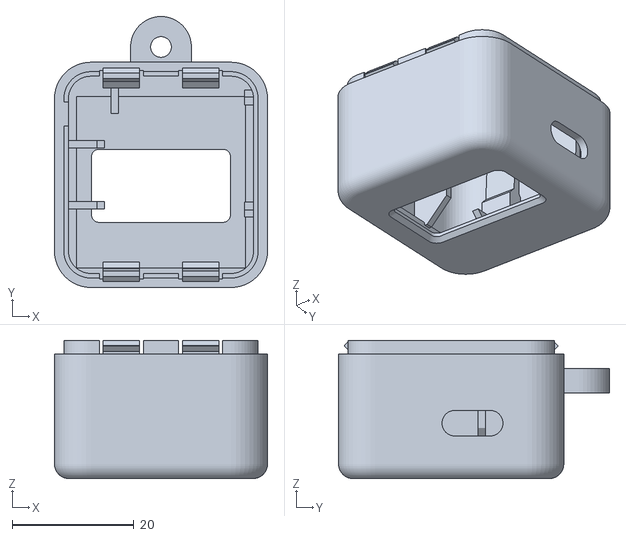
[picture p27: CAD file, 2026-11-04]
hardware/enclosure/stl/lumi_front_s3_tp4056.stl
35.0 x 44.5 x 22.7
