belivablelevi/Lumi/(list of files, cad)

Other CAD files:
hardware/enclosure/stl/lumi_back_s3_tp4056.stl
hardware/enclosure/stl/lumi_front.stl
hardware/enclosure/stl/lumi_back_s3.stl
hardware/enclosure/mini_lumi_pcb/mini_lumi_pcb.blend
