belivablelevi/Lumi/hardware/wiring.md

# Wiring

All modules share one I2C bus. Both the OLED and GY-521 boards already
carry I2C pull-up resistors, so no extra pull-ups are needed.

```
                 XIAO ESP32C3 (top view, USB-C at the top)
                  ┌──────────[USB-C]──────────┐
                D0│ GPIO2              5V     │
   IMU INT ──── D1│ GPIO3              GND    │──── GND (OLED, IMU, divider)
   divider ──── D2│ GPIO4              3V3    │──── VCC (OLED, IMU)
                D3│ GPIO5      GPIO10  D10    │
   SDA ──────── D4│ GPIO6      GPIO9   D9     │
   SCL ──────── D5│ GPIO7      GPIO8   D8     │
                D6│ GPIO21     GPIO20  D7     │
                  └───────────────────────────┘
                     back side: BAT+  BAT-  pads ── LiPo
```

| From | To | Notes |
|---|----|---|
| XIAO **3V3** | OLED **VCC**, GY-521 **VCC** | |
| XIAO **GND** | OLED **GND**, GY-521 **GND** | |
| XIAO **D4 / GPIO6** | OLED **SDA**, GY-521 **SDA** | I2C data |
| XIAO **D5 / GPIO7** | OLED **SCL**, GY-521 **SCL** | I2C clock |
| XIAO **D1 / GPIO3** | GY-521 **INT** | Wake-on-motion. It must be GPIO0–5: only those can wake the C3 from deep sleep. |
| XIAO **BAT+** pad | LiPo **+** (red) | Back of the XIAO. Mind the polarity! |
| XIAO **BAT−** pad | LiPo **−** (black) | |
| LiPo **+** → 220 kΩ → **D2 / GPIO4** → 220 kΩ → **GND** | | Battery voltage divider (1:2) |
| GY-521 **AD0** | leave unconnected | Pulled low on the board, so address 0x68 |
| GY-521 XDA, XCL | leave unconnected | |

Optional USB-power sense, so the battery screen shows "charging": wire
XIAO **5V** → 100 kΩ → **D3 / GPIO5** → 100 kΩ → **GND**, then set
`LUMI_PIN_USB_SENSE 5` in `firmware/src/config.h`.

## Pins to avoid

GPIO2, GPIO8 and GPIO9 are ESP32-C3 *strapping pins*. They decide the boot
mode, so don't hang anything on them that could pull them the wrong way at
power-up. The pin map above avoids them.

## IMU orientation

The firmware wants the accelerometer in "screen" axes: +X right, +Y up
toward the keyring, +Z out of the screen. In the reference build the GY-521
lies flat behind the XIAO with its **chip facing the back of the case** and
its printed **Y arrow pointing at the keyring**. If you mount it another
way, remap the axes in `config.h` (`LUMI_IMU_SCREEN_*`). The serial `i`
command prints live values to check against:

| Hold Lumi… | `i` should print gravity ≈ |
|---|---|
| hanging from its keyring | `y = +1` |
| lying face-up on a table | `z = +1` |
| with its right side down | `x = −1` |

## Trying the PCB's accelerometer (LIS2DH12) on today's build

The planned Lumi PCB ([pcb/PLAN.md](pcb/PLAN.md)) uses a **LIS2DH12**
instead of the MPU-6050. The firmware detects either one at start-up, so you
can try it before any PCB exists.

Wire a LIS2DH12 breakout board (about $2–3) in place of the GY-521. A LIS3DH
board also works, since it has the same registers.

| Breakout pin | To | Notes |
|---|---|---|
| **VCC / VIN** | XIAO **3V3** | |
| **GND** | **GND** | |
| **SDA** | **D4 / GPIO6** | |
| **SCL** | **D5 / GPIO7** | |
| **INT1** | **D1 / GPIO3** | Wake-on-motion, same as the GY-521's INT |
| **CS** | **3V3** | Selects I2C mode. Many boards already pull it up. |
| **SDO / SA0** | 3V3 (address 0x19) or GND (0x18) | Either works |

Then:
1. Remove the GY-521 or leave it unplugged. If both are fitted, the
   MPU-6050 is used.
2. Flash as usual. The serial monitor should print
   `lumi: accelerometer LIS2DH12 at 0x19`.
3. Type `i` with Lumi hanging from its keyring, lying face-up, and lying
   right side down. Adjust `LUMI_IMU_SCREEN_*` in `firmware/src/config.h`
   until they read `y = +1`, `z = +1` and `x = −1`. The breakout's arrows
   are printed on it.
4. Try pats, a double pat, a shake, and putting it to sleep and picking it
   up. If pats feel too light or too heavy, change `tapThreshold` in
   `firmware/lib/lumi_core/src/gestures.h`. The default is 0.45 g.

## Alternative: ESP32-S3 SuperMini

The firmware picks these pins automatically when built for the S3
(`pio run -e esp32s3_supermini -t upload`). The board's silkscreen shows
GPIO numbers.

| S3 SuperMini | To | Notes |
|---|---|---|
| **3V3** | OLED **VCC**, GY-521 **VCC** | |
| **GND** | OLED **GND**, GY-521 **GND**, divider bottom | |
| **GPIO5** | OLED **SDA**, GY-521 **SDA** | I2C data |
| **GPIO6** | OLED **SCL**, GY-521 **SCL** | I2C clock |
| **GPIO4** | GY-521 **INT** | Wake-on-motion. Must be GPIO0–21 (RTC pins). |
| **GPIO1** | Middle of the 220k + 220k divider from battery + | Battery voltage |

Avoid GPIO0, 3, 45 and 46 (strapping pins) and GPIO48 (the RGB LED).

**Power, depending on your board:**

- **Board with BAT+ / BAT− pads (built-in charger, e.g. HW-747):** solder
  the LiPo to those pads, exactly like the XIAO. Charging is through the
  board's own USB-C. Print `stl/lumi_front_s3.stl` + `lumi_back_s3.stl` (`board="s3"`).
- **Board without a charger:** add a TP4056 USB-C charger board with
  protection. LiPo → TP4056 **B+ / B−**; TP4056 **OUT+** → slide switch →
  SuperMini **5V** pin; **OUT−** → **GND**. Take the divider from **B+**.
  Charge through the TP4056's USB-C. **Turn the switch off before plugging
  USB into the SuperMini itself** (for flashing): otherwise its USB 5 V can
  feed back into the battery. Day to day, use Wi-Fi updates instead. Build
  `stl/lumi_front_s3_tp4056.stl` + `lumi_back_s3_tp4056.stl` (`board="s3_tp4056"`).
  Lower the TP4056's charge current first (see [TP4056 charge current](#tp4056-charge-current)).

Most S3 SuperMinis have an always-on power LED; remove it for decent
standby time, just like the GY-521's.

## Alternative: ESP32-C3 SuperMini + TP4056

The C3 SuperMini has the same chip as the XIAO, so it runs the same firmware
with the same GPIO numbers. Flash it with `pio run -e esp32c3_supermini -t upload`.
It has no charger, so it needs a TP4056 board as well. Its silkscreen shows GPIO
numbers.

| C3 SuperMini | To | Notes |
|---|---|---|
| **3.3** | OLED **VCC**, GY-521 **VCC** | |
| **G** | OLED **GND**, GY-521 **GND**, divider bottom, TP4056 **OUT−** | |
| **6** | OLED **SDA**, GY-521 **SDA** | I2C data |
| **7** | OLED **SCL**, GY-521 **SCL** | I2C clock |
| **3** | GY-521 **INT** | Wake-on-motion. Must be GPIO0–5. |
| **4** | Middle of the 220k + 220k divider from TP4056 **B+** | Battery voltage |
| **5V** | Schottky diode from TP4056 **OUT+** (stripe towards the 5V pin) | Battery power in. SS14 (SMD) or 1N5817. |

LiPo **+** goes to TP4056 **B+** and LiPo **−** to **B−**. Leave GPIO2, 8 and 9
free: they're strapping pins, GPIO8 drives the blue LED and GPIO9 is the BOOT
button.

The case is the same as for the S3 SuperMini with a TP4056, 32.2 mm deep instead
of 25.5 mm: print `stl/lumi_front_s3_tp4056.stl` + `lumi_back_s3_tp4056.stl`
(`board="c3_tp4056"` gives the same parts). The TP4056 sits in its own layer
under the IMU, with its USB-C out of the left side. Charge through that port.

The case has no opening for a switch, so use the diode instead. When USB is
plugged into the SuperMini for flashing, it stops the 5 V feeding back into the
battery, which would overcharge it. It costs about 0.3 V, so the board browns
out a little before the cell is completely flat. That's fine for prototypes.
Without a diode, unplug the battery before plugging USB into the SuperMini.

Also:
- **Remove the SuperMini's red power LED.** It stays lit all the time and
  would flatten the battery in days.
- **Lower the TP4056's charge current** (below).

If the Wi-Fi or Tilt Pong range is poor, try a different board before blaming
the firmware. Some C3 SuperMini batches have weak antennas.

## TP4056 charge current

Most TP4056 boards charge at 1 A. That's more than three times the
300 mAh cell's capacity, which heats and wears it and isn't safe in a closed
case. The current is set by one resistor, R_PROG, connected to the TP4056's
pin 2 (PROG). It's usually labelled **R3** and marked **122** (1.2 kΩ).
Replace it before you connect the battery:

| R_PROG | Marking | Charge current | For the 300 mAh cell |
|---|---|---|---|
| 1.2 kΩ | 122 | 1 A | Too high |
| 4.7 kΩ | 472 | ≈ 255 mA | The most it should take (≈ 0.85C) |
| 8.2 kΩ | 822 | ≈ 145 mA | Gentlest, about 2½ h to full (recommended) |

A 0603 or 0805 resistor of the same size as the old one fits the pads. Check
the current with a USB power meter on the first unit: it should read close to
the table while the battery is low.
