belivablelevi/Lumi/docs/print/lumi-odds-card-letter.pdf

# POCKET LUMI · PERSONALITY GUIDE

# Meet your Lumi

# No two Lumis are alike. Its looks and temperament were picked by

# chance when it was made. Here’s how likely each one is. How rare is yours?

# Common

60%

# Uncommon

25%

Rare
12%

# Legendary

3%

# Temperament how it acts

# Cheerful 30%

# Giggles when you pat it, hums and dances. Sleepy 20%

# Tires quickly. Yawns, zones out and nods o. Shy 20%

# Blushes and squishes up when you pat it. Grumpy 15%

# Side-eyes and pouts, but secretly loves a pat. Hyper 15%

Bouncy and quick. Dances until it goes cross-eyed. To see your Lumi’s name and rarity, hold it upside down until the menu opens, then tilt to

BATTERY and pat it. POCKET LUMI · PERSONALITY GUIDE Meet your Lumi No two Lumis are alike. Its looks and temperament were picked by chance when it was made. Here’s how likely each one is. How rare is yours? Common 60% Uncommon 25% Rare 12% Legendary 3% Temperament how it acts Cheerful 30% Giggles when you pat it, hums and dances. Sleepy 20% Tires quickly. Yawns, zones out and nods o. Shy 20% Blushes and squishes up when you pat it. Grumpy 15% Side-eyes and pouts, but secretly loves a pat. Hyper 15% Bouncy and quick. Dances until it goes cross-eyed. To see your Lumi’s name and rarity, hold it upside down until the menu opens, then tilt to BATTERY and pat it. Print at 100% (actual size), double-sided, flip on long edge. Cut on the marks.

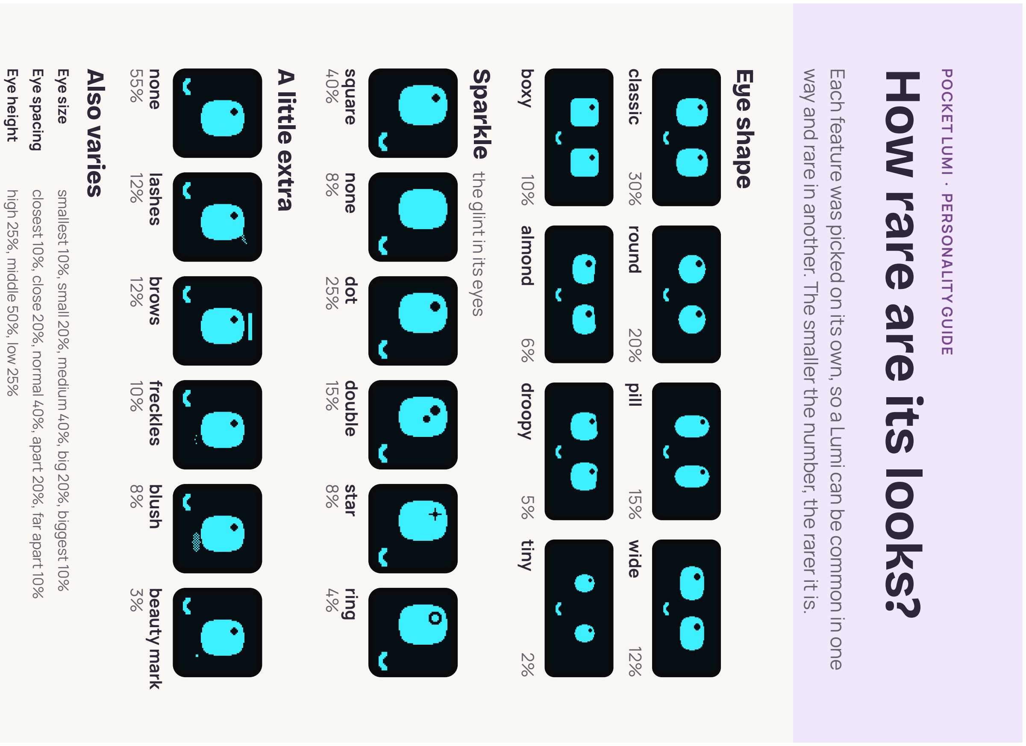
[picture p33: figure]
POCKET LUMI · PERSONALITY GUIDE; How rare are its looks?; classic 30% round 20% pill 15% wide 12%; boxy 10% almond 6% droopy 5% tiny 2%; Sparkle the glint in its eyes; square; none; dot; double; star; ring; A little extra; lashes; brows; freckles; blush; beauty mark; Also varies

# Each feature was picked on its own, so a Lumi can be common in one

# way and rare in another. The smaller the number, the rarer it is. Eye shape

# Eye size smallest 10%, small 20%, medium 40%, big 20%, biggest 10%

# Eye spacing closest 10%, close 20%, normal 40%, apart 20%, far apart 10%

# Eye height high 25%, middle 50%, low 25%

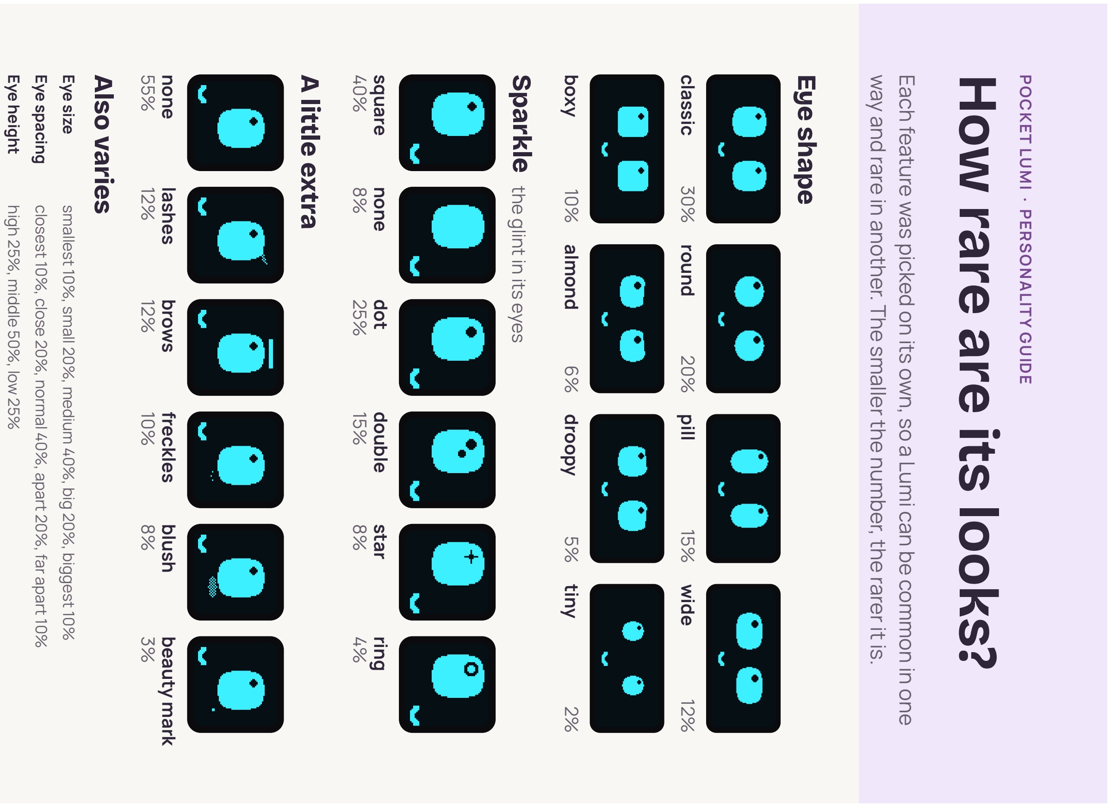
[picture p34: figure]
POCKET LUMI · PERSONALITY GUIDE; How rare are its looks?; classic 30% round 20% pill 15% wide 12%; boxy 10% almond 6% droopy 5% tiny 2%; Sparkle the glint in its eyes; square; none; dot; double; star; ring; A little extra; lashes; brows; freckles; blush; beauty mark; Also varies

# Each feature was picked on its own, so a Lumi can be common in one

# way and rare in another. The smaller the number, the rarer it is. Eye shape

# Eye size smallest 10%, small 20%, medium 40%, big 20%, biggest 10%

# Eye spacing closest 10%, close 20%, normal 40%, apart 20%, far apart 10%

# Eye height high 25%, middle 50%, low 25%
