belivablelevi/Lumi/docs/print/lumi-odds-card.pdf

POCKET LUMI · PERSONALITY GUIDE

# Meet your Lumi

No two Lumis are alike. Its looks and temperament were picked by chance when it was made. Here’s how likely each one is.

### How rare is yours?

Common
60%

Uncommon
25%

Rare
12%

Legendary
3%

### Temperament how it acts

Cheerful | 30%
Giggles when you pat it, hums and dances.
Sleepy | 20%
Tires quickly. Yawns, zones out and nods o.
Shy | 20%
Blushes and squishes up when you pat it.
Grumpy | 15%
Side-eyes and pouts, but secretly loves a pat.
Hyper | 15%
Bouncy and quick. Dances until it goes cross-eyed.

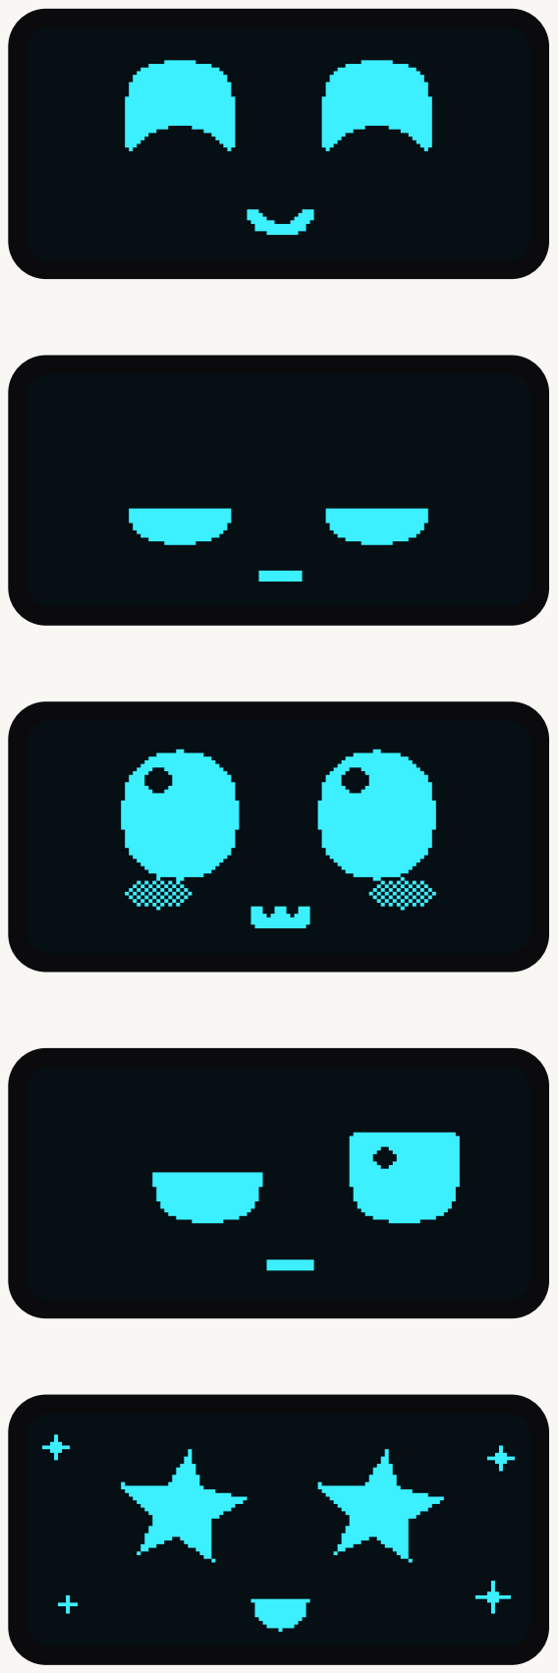
[picture p35: figure]

To see your Lumi’s name and rarity, hold it upside down until the menu opens, then tilt to BATTERY and pat it.

POCKET LUMI · PERSONALITY GUIDE

# How rare are its looks?

Each feature was picked on its own, so a Lumi can be common in one way and rare in another. The smaller the number, the rarer it is.

### Eye shape

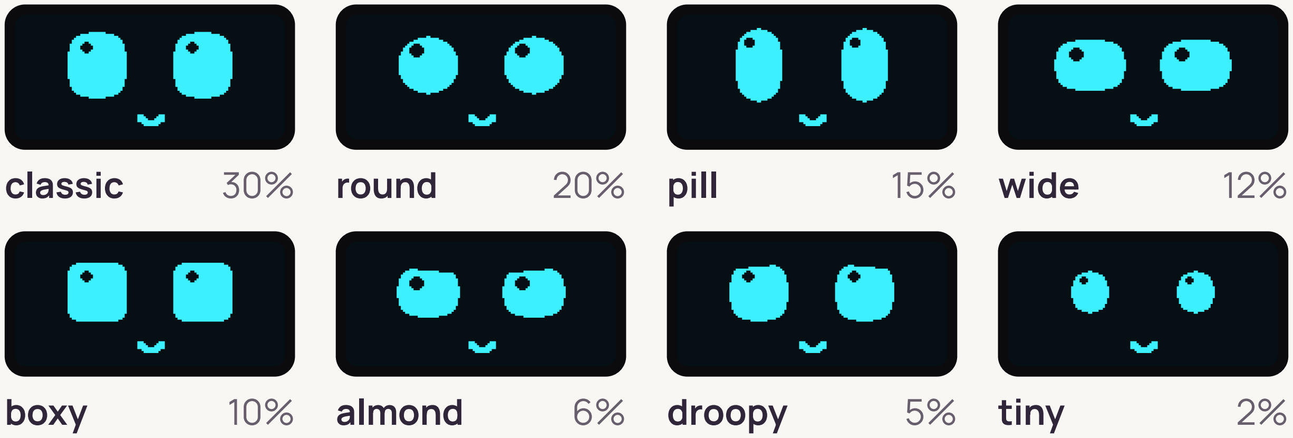
[picture p36: figure]
classic; 30% round; 20% pill; 15% wide; boxy; 10% almond; 6% droopy; 5% tiny

Sparkle the glint in its eyes

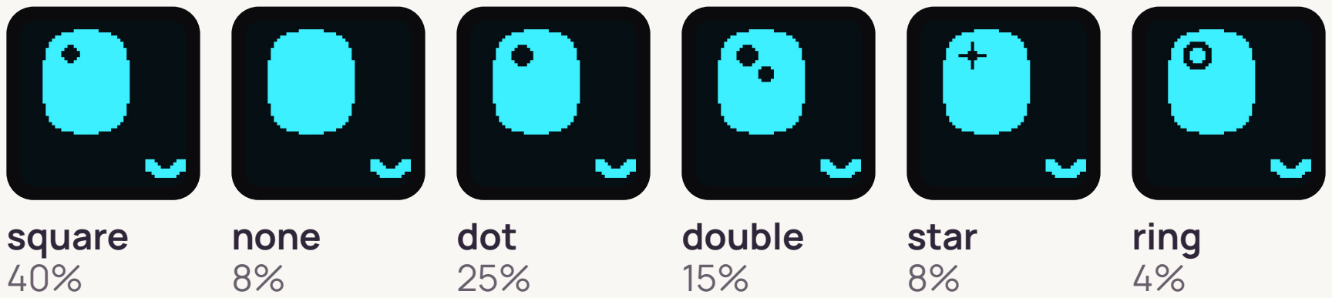
[picture p37: figure]
square 40%; none 8%; dot 25%; double 15%; star 8%; ring 4%

### A little extra

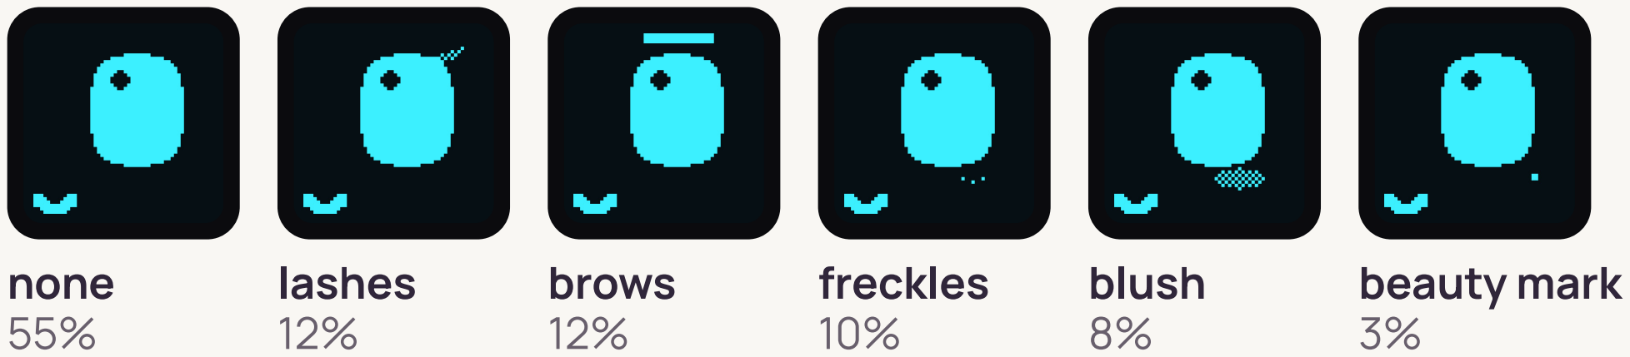
[picture p38: figure]
none 55%; lashes 12%; brows 12%; freckles 10%; blush 8%; beauty mark 3%

### Also varies

Eye size | smallest 10%, small 20%, medium 40%, big 20%, biggest 10%
Eye spacing | closest 10%, close 20%, normal 40%, apart 20%, far apart 10%
Eye height | high 25%, middle 50%, low 25%
