belivablelevi/Lumi/hardware/pcb/kicad/fab/lumi-schematic.pdf

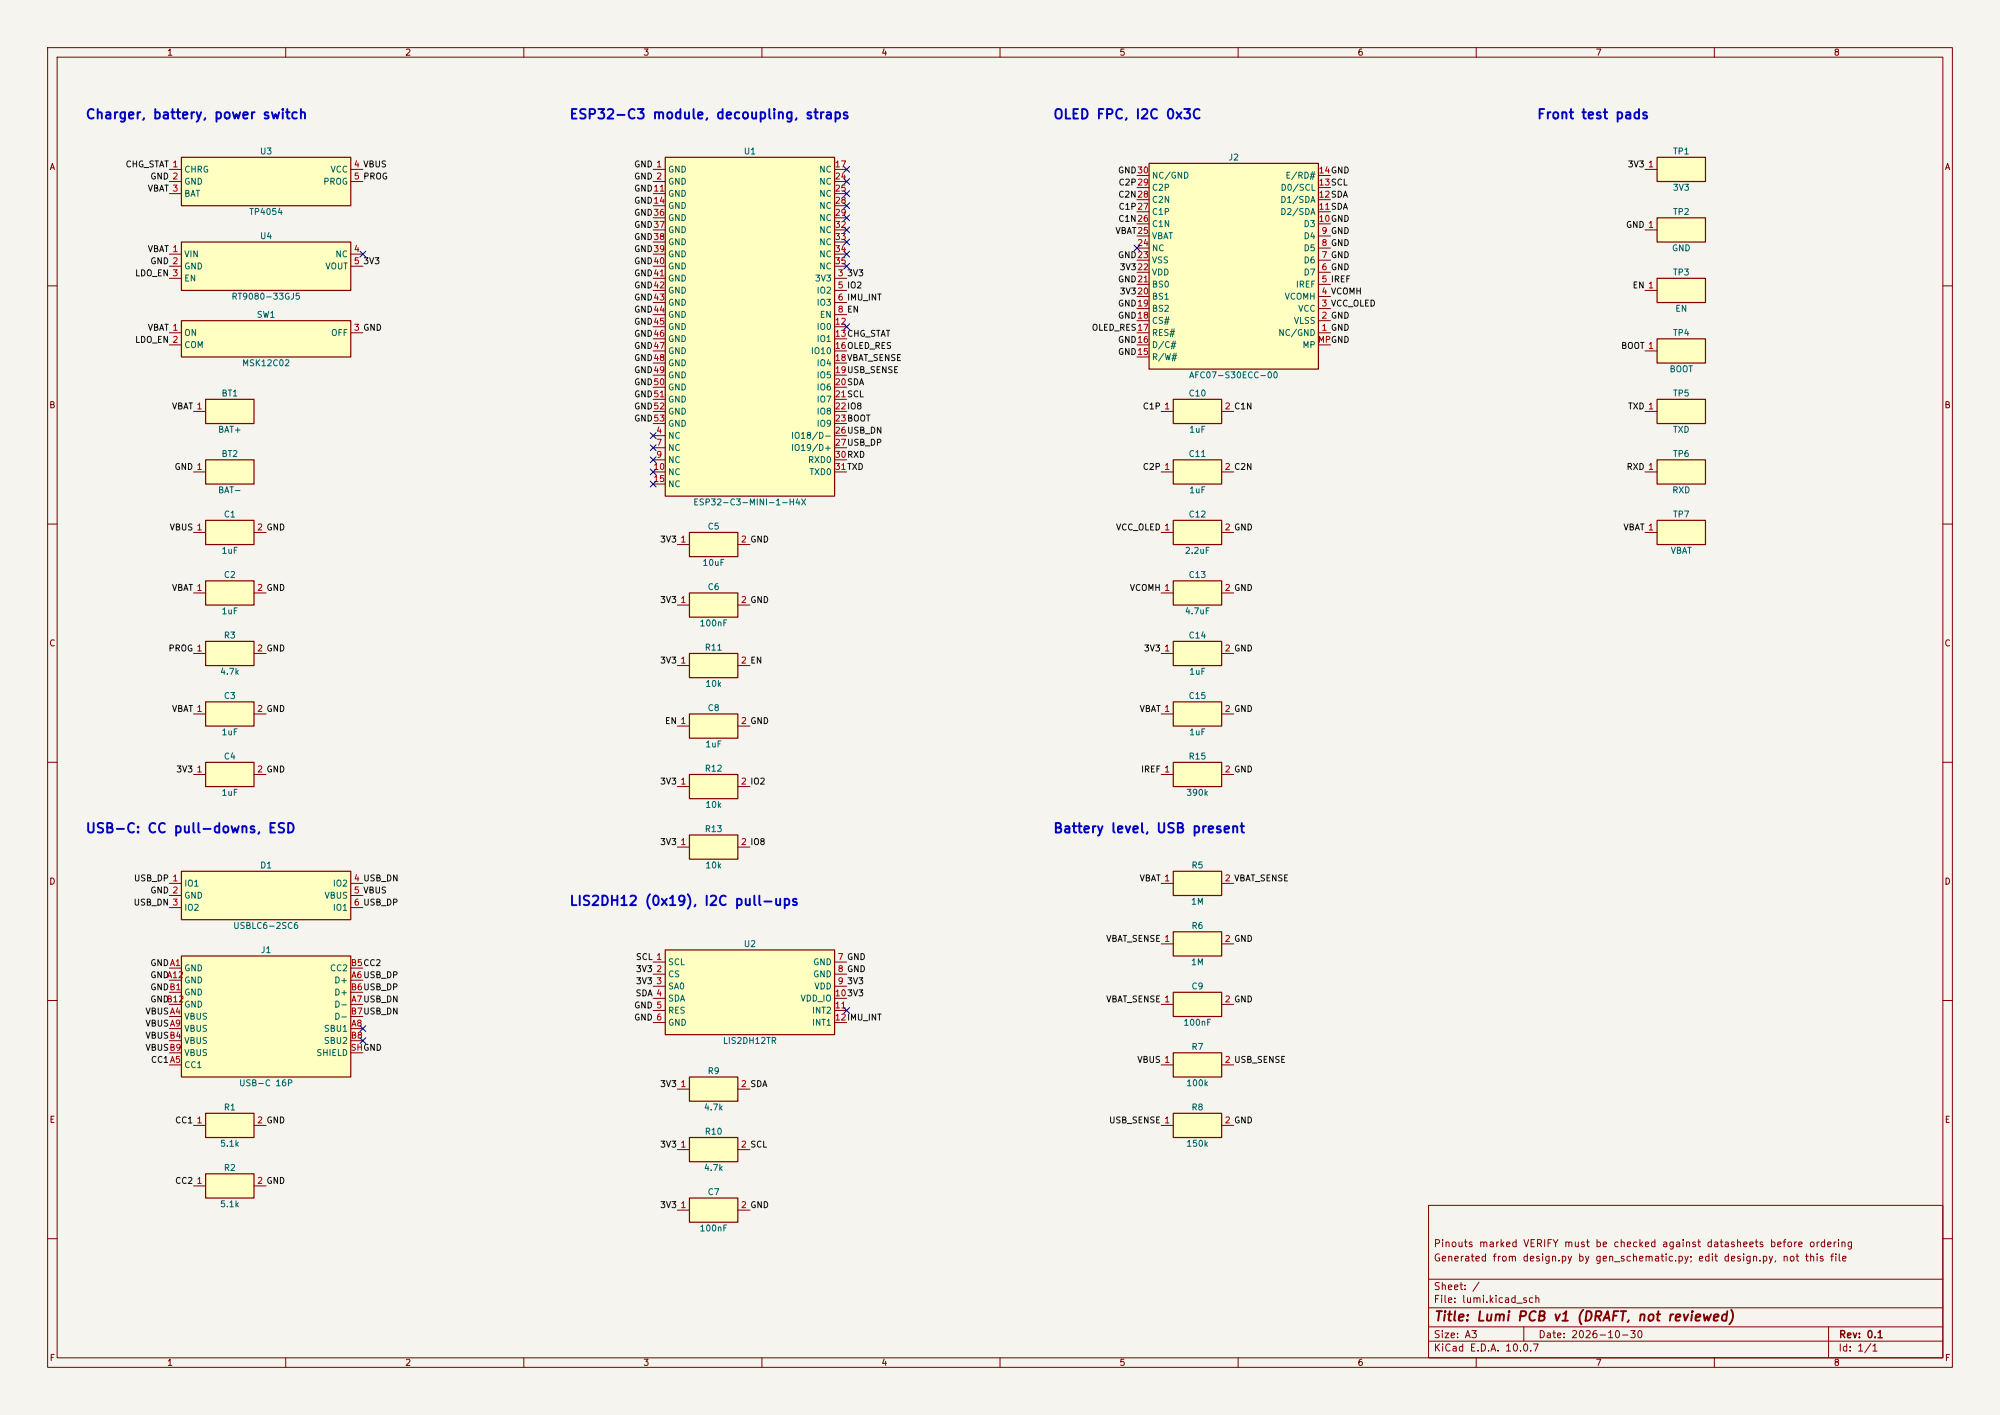
[picture p39: page 1]

Pinouts marked VERIFY must be checked against datasheets before ordering
Generated from design.py by gen_schematic.py; edit design.py, not this file

Sheet: /
File: lumi.kicad_sch
Title: Lumi PCB v1 (DRAFT, not reviewed)

Size: A3 | Rev: 0.1 | F Date: 2026-10-30
KiCad E.D.A. 10.0.7 | Id: 1/1
