belivablelevi/Lumi/hardware/pcb/kicad/lumi/lumi.kicad_pcb

## KiCad design hardware/pcb/kicad/lumi/lumi.kicad_pcb (2026-11-06)

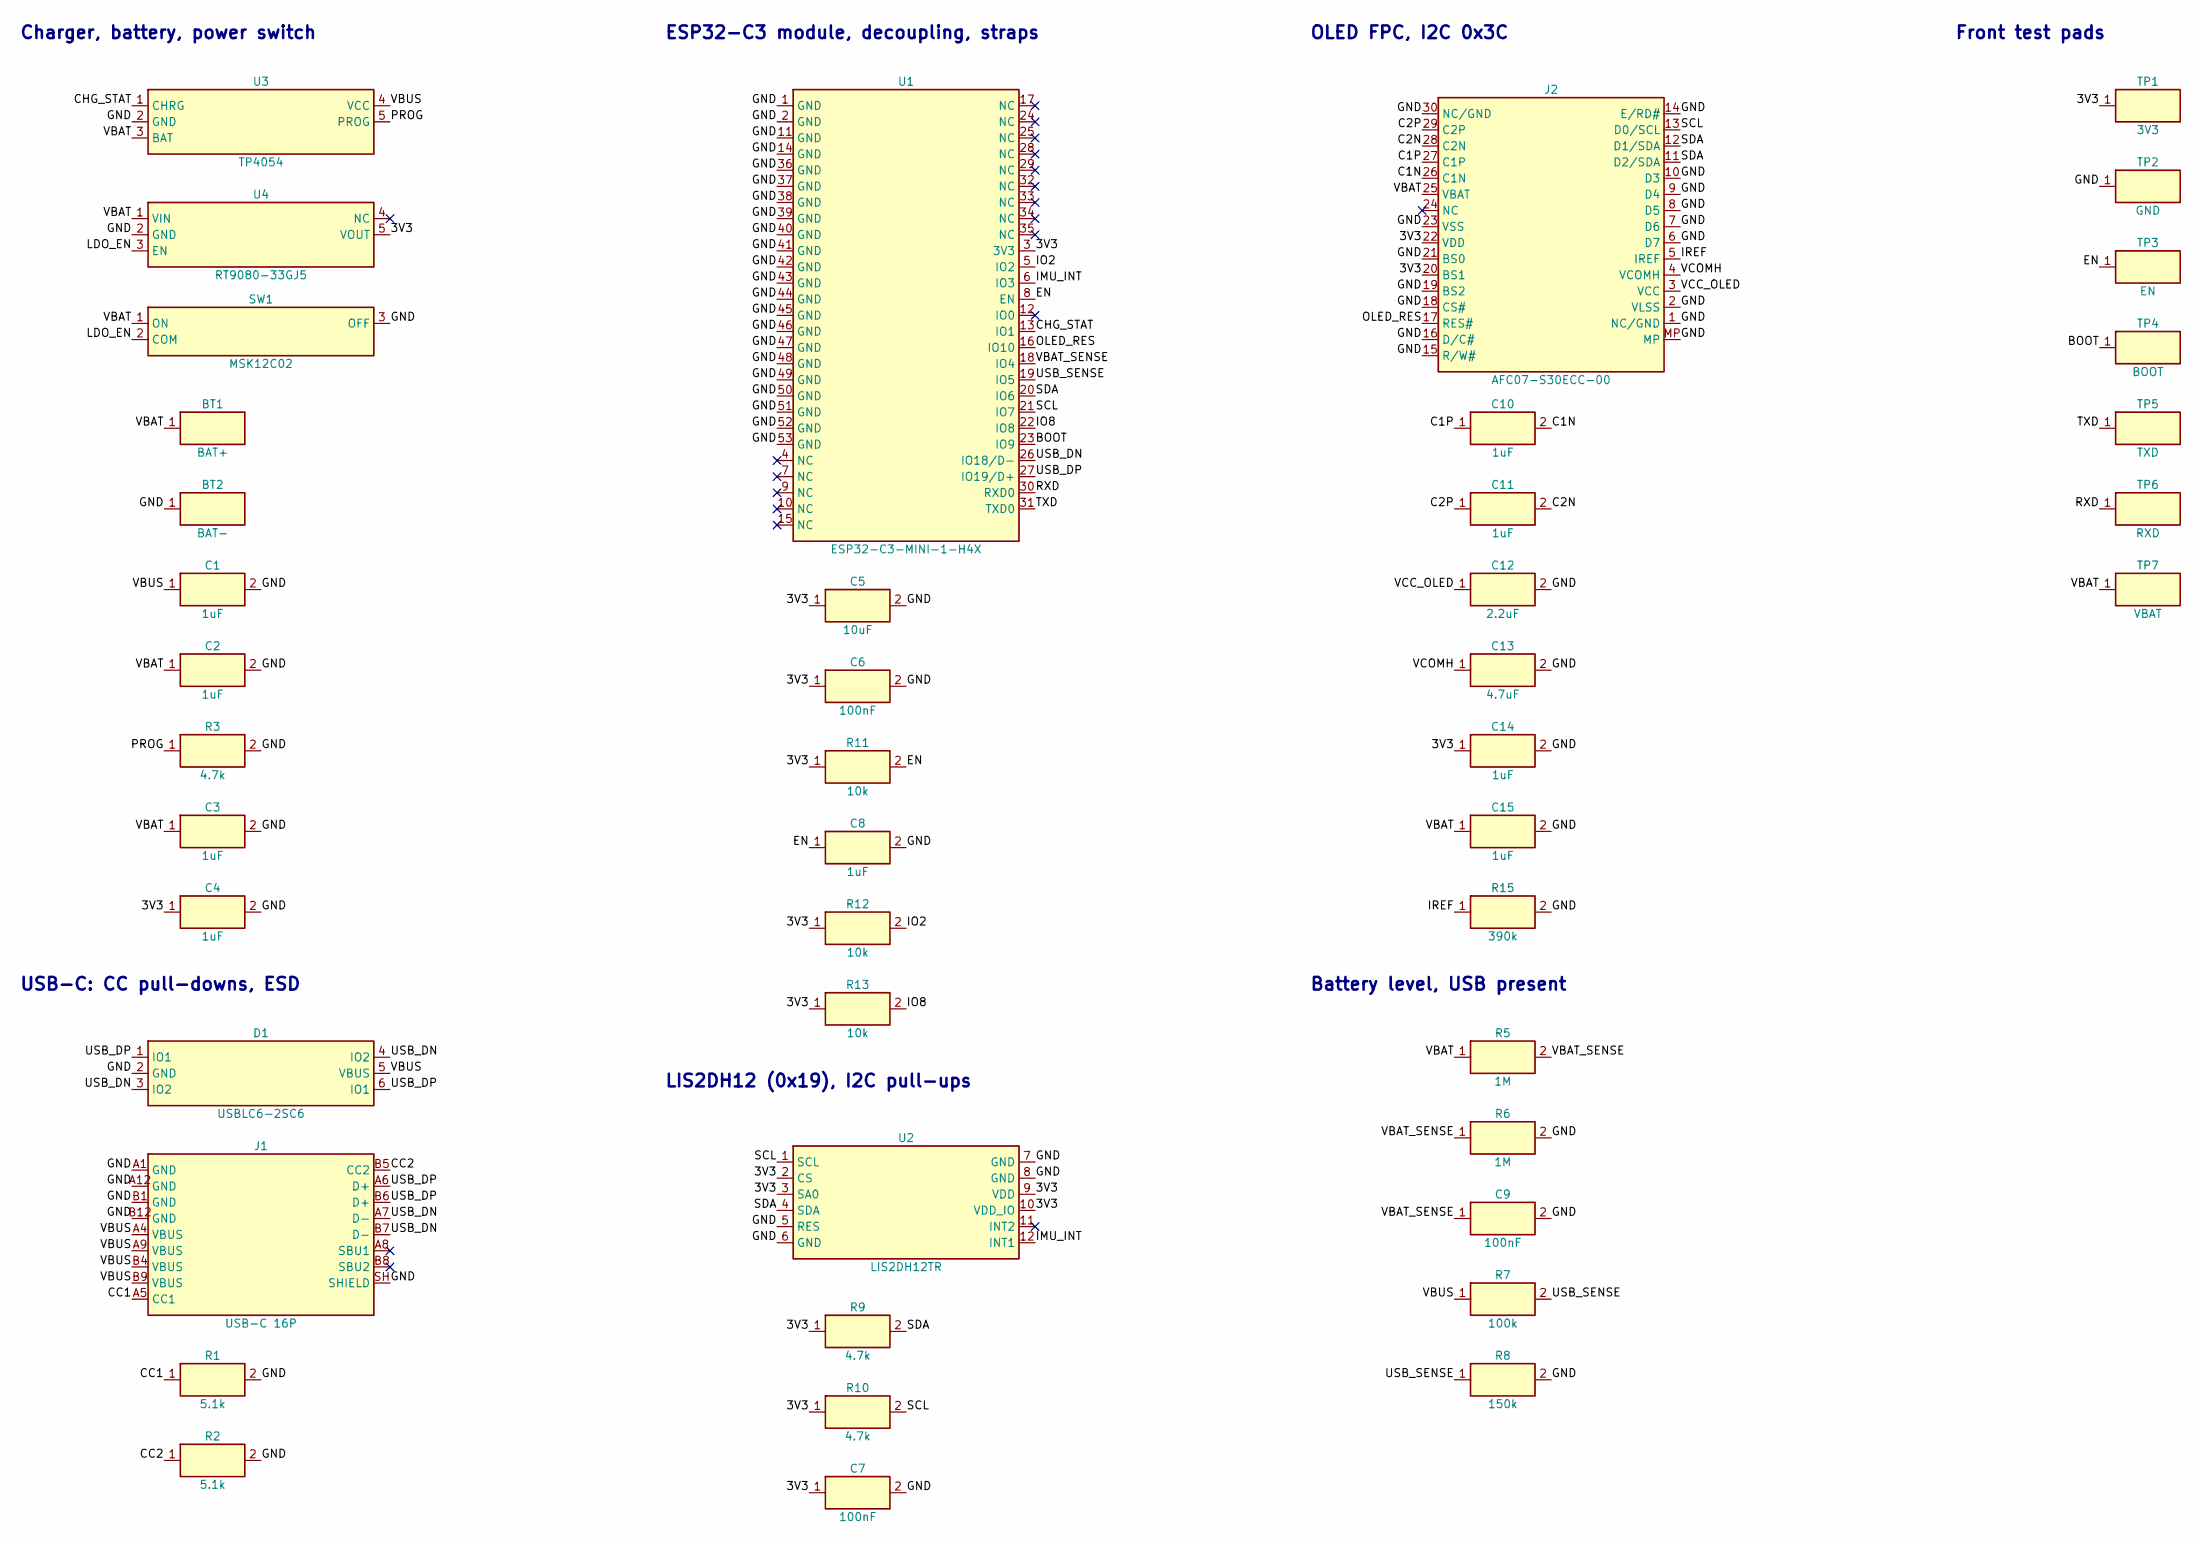
[picture p40: schematic lumi.kicad_sch, Lumi PCB v1 (DRAFT, not reviewed)]

Parts:
BT1: BAT+; TestPoint_Pad_1.5x1.5mm
BT2: BAT-; TestPoint_Pad_1.5x1.5mm
C1, C2, C3, C4, C8, C10, C11, C14, C15: 1uF; C_0402_1005Metric; LCSC C52923
C5: 10uF; C_0402_1005Metric; LCSC C15525
C6, C7, C9: 100nF; C_0402_1005Metric; LCSC C1525
C12: 2.2uF; C_0603_1608Metric; LCSC C23630
C13: 4.7uF; C_0603_1608Metric; LCSC C19666
D1: USBLC6-2SC6; SOT-23-6; LCSC C7519
J1: USB-C 16P; USB_C_Receptacle_HRO_TYPE-C-31-M-12; LCSC C165948
J2: AFC07-S30ECC-00; JUSHUO_AFC07-S30ECC-00; LCSC C11095
R1, R2: 5.1k; R_0402_1005Metric; LCSC C25905
R3, R9, R10: 4.7k; R_0402_1005Metric; LCSC C25900
R5, R6: 1M; R_0402_1005Metric; LCSC C26083
R7: 100k; R_0402_1005Metric; LCSC C25741
R8: 150k; R_0402_1005Metric; LCSC C25755
R11, R12, R13: 10k; R_0402_1005Metric; LCSC C25744
R15: 390k; R_0402_1005Metric; LCSC C25782
SW1: MSK12C02; LCSC C431540
TP1: 3V3; TestPoint_Pad_D1.0mm
TP2: GND; TestPoint_Pad_D1.0mm
TP3: EN; TestPoint_Pad_D1.0mm
TP4: BOOT; TestPoint_Pad_D1.0mm
TP5: TXD; TestPoint_Pad_D1.0mm
TP6: RXD; TestPoint_Pad_D1.0mm
TP7: VBAT; TestPoint_Pad_D1.0mm
U1: ESP32-C3-MINI-1-H4X; ESP32-C3-MINI-1; LCSC C41349510
U2: LIS2DH12TR; LGA-12_2x2mm_P0.5mm; LCSC C110926
U3: TP4054; SOT-23-5; LCSC C32574
U4: RT9080-33GJ5; SOT-23-5; LCSC C841192

Connections:
3V3: C4.1, C5.1, C6.1, C7.1, C14.1, J2.20 (BS1), J2.22 (VDD), R9.1, R10.1, R11.1, R12.1, R13.1, TP1.1, U1.3 (3V3), U2.2 (CS), U2.3 (SA0), U2.9 (VDD), U2.10 (VDD_IO), U4.5 (VOUT)
BOOT: TP4.1, U1.23 (IO9)
C1N: C10.2, J2.26 (C1N)
C1P: C10.1, J2.27 (C1P)
C2N: C11.2, J2.28 (C2N)
C2P: C11.1, J2.29 (C2P)
CC1: J1.A5 (CC1), R1.1
CC2: J1.B5 (CC2), R2.1
CHG_STAT: U1.13 (IO1), U3.1 (CHRG)
EN: C8.1, R11.2, TP3.1, U1.8 (EN)
GND: BT2.1, C1.2, C2.2, C3.2, C4.2, C5.2, C6.2, C7.2, C8.2, C9.2, C12.2, C13.2, C14.2, C15.2, D1.2 (GND), J1.A1 (GND), J1.A12 (GND), J1.B1 (GND), J1.B12 (GND), J1.SH (SHIELD), J2.1 (NC/GND), J2.2 (VLSS), J2.6 (D7), J2.7 (D6), J2.8 (D5), J2.9 (D4), J2.10 (D3), J2.14 (E/RD#), J2.15 (R/W#), J2.16 (D/C#), J2.18 (CS#), J2.19 (BS2), J2.21 (BS0), J2.23 (VSS), J2.30 (NC/GND), J2.MP, R1.2, R2.2, R3.2, R6.2, R8.2, R15.2, SW1.3 (OFF), TP2.1, U1.1 (GND), U1.2 (GND), U1.11 (GND), U1.14 (GND), U1.36 (GND), U1.37 (GND), U1.38 (GND), U1.39 (GND), U1.40 (GND), U1.41 (GND), U1.42 (GND), U1.43 (GND), U1.44 (GND), U1.45 (GND), U1.46 (GND), U1.47 (GND), U1.48 (GND), U1.49 (GND), U1.50 (GND), U1.51 (GND), U1.52 (GND), U1.53 (GND), U2.5 (RES), U2.6 (GND), U2.7 (GND), U2.8 (GND), U3.2 (GND), U4.2 (GND)
IMU_INT: U1.6 (IO3), U2.12 (INT1)
IO2: R12.2, U1.5 (IO2)
IO8: R13.2, U1.22 (IO8)
IREF: J2.5 (IREF), R15.1
LDO_EN: SW1.2 (COM), U4.3 (EN)
OLED_RES: J2.17 (RES#), U1.16 (IO10)
PROG: R3.1, U3.5 (PROG)
RXD: TP6.1, U1.30 (RXD0)
SCL: J2.13 (D0/SCL), R10.2, U1.21 (IO7), U2.1 (SCL)
SDA: J2.11 (D2/SDA), J2.12 (D1/SDA), R9.2, U1.20 (IO6), U2.4 (SDA)
TXD: TP5.1, U1.31 (TXD0)
USB_DN: D1.3 (IO2), D1.4 (IO2), J1.A7 (D-), J1.B7 (D-), U1.26 (IO18/D-)
USB_DP: D1.1 (IO1), D1.6 (IO1), J1.A6 (D+), J1.B6 (D+), U1.27 (IO19/D+)
USB_SENSE: R7.2, R8.1, U1.19 (IO5)
VBAT: BT1.1, C2.1, C3.1, C15.1, J2.25 (VBAT), R5.1, SW1.1 (ON), TP7.1, U3.3 (BAT), U4.1 (VIN)
VBAT_SENSE: C9.1, R5.2, R6.1, U1.18 (IO4)
VBUS: C1.1, D1.5 (VBUS), J1.A4 (VBUS), J1.A9 (VBUS), J1.B4 (VBUS), J1.B9 (VBUS), R7.1, U3.4 (VCC)
VCC_OLED: C12.1, J2.3 (VCC)
VCOMH: C13.1, J2.4 (VCOMH)

Notes on the sheet:
Charger, battery, power switch
USB-C: CC pull-downs, ESD
ESP32-C3 module, decoupling, straps
LIS2DH12 (0x19), I2C pull-ups
OLED FPC, I2C 0x3C
Battery level, USB present
Front test pads

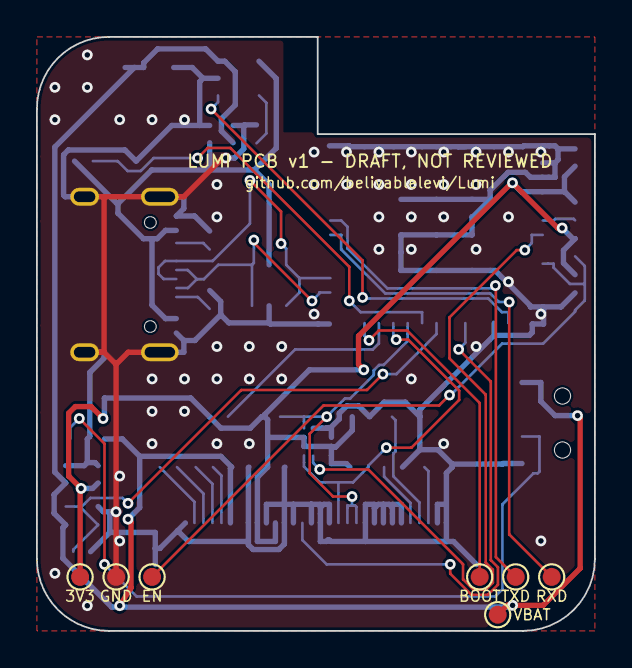
[picture p41: board lumi.kicad_pcb from above]

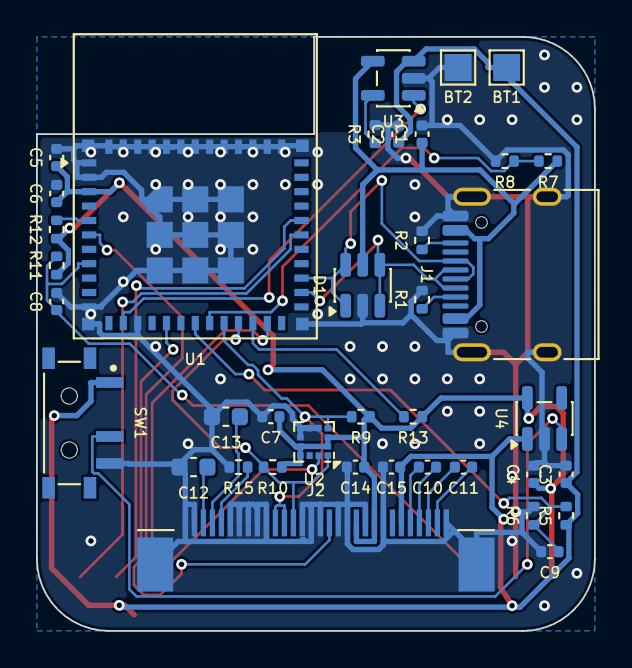
[picture p42: board lumi.kicad_pcb from below]

Board: 2 copper layers, 31.0 x 33.0 mm, 45 parts (38 on the bottom side), 30 nets.
