belivablelevi/Lumi/hardware/pcb/kicad/design.py

"""Lumi PCB v1: parts and connections, the single source of truth.

gen_schematic.py draws the schematic from this file and gen_board.py builds
the board from it, so the two can't drift apart. Change a connection here,
then run build.sh.

DRAFT. Pinouts marked VERIFY come from memory or from similar parts, not
from the part's own datasheet. Check every one before ordering
(see ../GUIDE.md).
"""

from dataclasses import dataclass, field

# Seen from the front with the cable at the bottom, the panel's pin 1 is on
# the left (datasheet drawing 1.4.2), so it reaches J2 at the board's low-x
# end. That's J2's pad 30 as placed, so panel pin N lands on pad 31 - N.
OLED_PIN_REVERSED = True


@dataclass
class Part:
    ref: str
    value: str
    footprint: str            # KiCad library:footprint
    pins: dict                # pad number -> net name (None = not connected)
    names: dict = field(default_factory=dict)   # pad number -> pin name (schematic)
    lcsc: str = ""
    note: str = ""
    block: str = ""           # schematic group
    bom: bool = True          # False for bare pads (test points, battery pads)


R0402 = "Resistor_SMD:R_0402_1005Metric"
C0402 = "Capacitor_SMD:C_0402_1005Metric"
C0603 = "Capacitor_SMD:C_0603_1608Metric"
TP = "TestPoint:TestPoint_Pad_D1.0mm"
BATPAD = "TestPoint:TestPoint_Pad_1.5x1.5mm"

# Passives, JLCPCB "Basic" (no loading fee) except 150k and 390k, which have no
# Basic part. verify_parts.py checks each number's value and stock against
# JLCPCB's library; values matter, the exact maker doesn't.
LCSC_R = {"5.1k": "C25905", "1M": "C26083", "100k": "C25741", "150k": "C25755",
          "4.7k": "C25900", "10k": "C25744", "390k": "C25782"}
LCSC_C = {("100nF", C0402): "C1525", ("1uF", C0402): "C52923",
          ("10uF", C0402): "C15525", ("1uF", C0603): "C15849",
          ("2.2uF", C0603): "C23630", ("4.7uF", C0603): "C19666"}


def R(ref, value, a, b, block, note=""):
    return Part(ref, value, R0402, {"1": a, "2": b}, lcsc=LCSC_R[value],
                note=note, block=block)


def C(ref, value, a, b, block, fp=C0402, note=""):
    return Part(ref, value, fp, {"1": a, "2": b}, lcsc=LCSC_C[(value, fp)],
                note=note, block=block)


# ---------------------------------------------------------------- module
# ESP32-C3-MINI-1 pin map (Espressif datasheet v2.2, Table 3-1; LCSC's symbol
# for C41349510 agrees). 53 pads: 1-48 round the edge, 49 the 3 x 3 ground
# array in the middle, 50-53 the corner pads.
MINI_GND = ["1", "2", "11", "14"] + [str(n) for n in range(36, 54)]
MINI_NC = ["4", "7", "9", "10", "15", "17", "24", "25", "28", "29", "32", "33", "34", "35"]
MINI_NAMES = {
    **{p: "GND" for p in MINI_GND}, **{p: "NC" for p in MINI_NC},
    "3": "3V3", "5": "IO2", "6": "IO3", "8": "EN", "12": "IO0", "13": "IO1",
    "16": "IO10", "18": "IO4", "19": "IO5", "20": "IO6", "21": "IO7",
    "22": "IO8", "23": "IO9", "26": "IO18/D-", "27": "IO19/D+",
    "30": "RXD0", "31": "TXD0",
}
U1 = Part("U1", "ESP32-C3-MINI-1-H4X", "lumi:ESP32-C3-MINI-1", {
    **{p: "GND" for p in MINI_GND}, **{p: None for p in MINI_NC},
    "3": "3V3", "5": "IO2", "6": "IMU_INT", "8": "EN", "12": None,
    "13": "CHG_STAT", "16": "OLED_RES", "18": "VBAT_SENSE", "19": "USB_SENSE",
    "20": "SDA", "21": "SCL", "22": "IO8", "23": "BOOT", "26": "USB_DN",
    "27": "USB_DP", "30": "RXD", "31": "TXD",
}, MINI_NAMES, lcsc="C41349510", block="MCU",
    note="Radio-certified module (chip revision v1.1; the -N4 is not recommended "
         "for new designs). Antenna at the keyring edge; keep copper out of the marked area.")

# ---------------------------------------------------------------- motion
U2 = Part("U2", "LIS2DH12TR", "Package_LGA:LGA-12_2x2mm_P0.5mm", {
    "1": "SCL", "2": "3V3", "3": "3V3", "4": "SDA", "5": "GND", "6": "GND",
    "7": "GND", "8": "GND", "9": "3V3", "10": "3V3", "11": None, "12": "IMU_INT",
}, {"1": "SCL", "2": "CS", "3": "SA0", "4": "SDA", "5": "RES", "6": "GND",
    "7": "GND", "8": "GND", "9": "VDD", "10": "VDD_IO", "11": "INT2", "12": "INT1"},
    lcsc="C110926", block="Motion",
    note="CS high = I2C. SA0 high = address 0x19. RES must go to GND.")

# ---------------------------------------------------------------- power
J1 = Part("J1", "USB-C 16P", "Connector_USB:USB_C_Receptacle_HRO_TYPE-C-31-M-12", {
    "A1": "GND", "A12": "GND", "B1": "GND", "B12": "GND",
    "A4": "VBUS", "A9": "VBUS", "B4": "VBUS", "B9": "VBUS",
    "A5": "CC1", "B5": "CC2",
    "A6": "USB_DP", "B6": "USB_DP", "A7": "USB_DN", "B7": "USB_DN",
    "A8": None, "B8": None, "SH": "GND",
}, {"A1": "GND", "A12": "GND", "B1": "GND", "B12": "GND", "A4": "VBUS",
    "A9": "VBUS", "B4": "VBUS", "B9": "VBUS", "A5": "CC1", "B5": "CC2",
    "A6": "D+", "B6": "D+", "A7": "D-", "B7": "D-", "A8": "SBU1", "B8": "SBU2",
    "SH": "SHIELD"}, lcsc="C165948", block="USB")

D1 = Part("D1", "USBLC6-2SC6", "Package_TO_SOT_SMD:SOT-23-6", {
    "1": "USB_DP", "2": "GND", "3": "USB_DN", "4": "USB_DN", "5": "VBUS",
    "6": "USB_DP",
}, {"1": "IO1", "2": "GND", "3": "IO2", "4": "IO2", "5": "VBUS", "6": "IO1"},
    lcsc="C7519", block="USB", note="USB ESD protection.")

U3 = Part("U3", "TP4054", "Package_TO_SOT_SMD:SOT-23-5", {
    "1": "CHG_STAT", "2": "GND", "3": "VBAT", "4": "VBUS", "5": "PROG",
}, {"1": "CHRG", "2": "GND", "3": "BAT", "4": "VCC", "5": "PROG"},
    lcsc="C32574", block="Power",
    note="LiPo charger. CHRG is open-drain: firmware enables the IO1 pull-up. VERIFY pinout.")

U4 = Part("U4", "RT9080-33GJ5", "Package_TO_SOT_SMD:SOT-23-5", {
    "1": "VBAT", "2": "GND", "3": "LDO_EN", "4": None, "5": "3V3",
}, {"1": "VIN", "2": "GND", "3": "EN", "4": "NC", "5": "VOUT"},
    lcsc="C841192", block="Power", note="3.3 V LDO, 2 uA standby. VERIFY pinout.")

SW1 = Part("SW1", "MSK12C02", "lumi:MSK12C02", {
    "1": "VBAT", "2": "LDO_EN", "3": "GND",
}, {"1": "ON", "2": "COM", "3": "OFF"}, lcsc="C431540", block="Power",
    note="Power switch on the LDO enable (microamps), not on the battery. "
         "Its own footprint: KiCad's PCM12 puts the mounting pads and pegs 0.5 mm off for this part.")

BT1 = Part("BT1", "BAT+", BATPAD, {"1": "VBAT"}, {"1": "+"}, block="Power",
           bom=False, note="Battery red wire (protected 503030 LiPo).")
BT2 = Part("BT2", "BAT-", BATPAD, {"1": "GND"}, {"1": "-"}, block="Power",
           bom=False, note="Battery black wire.")

# ---------------------------------------------------------------- screen
# BuyDisplay ER-OLED0.96-1.3 pinout (ER-OLED0.96-1 datasheet rev 2.0, drawing
# 1.4.2 and section 1.5). The charge pump's VBAT pin needs 3.5-4.2 V, so it
# runs from the battery rail, not the 3.3 V regulator.
OLED = {
    1: ("NC/GND", "GND"), 2: ("C2P", "C2P"), 3: ("C2N", "C2N"),
    4: ("C1P", "C1P"), 5: ("C1N", "C1N"), 6: ("VBAT", "VBAT"), 7: ("NC", None),
    8: ("VSS", "GND"), 9: ("VDD", "3V3"), 10: ("BS0", "GND"),
    11: ("BS1", "3V3"), 12: ("BS2", "GND"), 13: ("CS#", "GND"),
    14: ("RES#", "OLED_RES"), 15: ("D/C#", "GND"), 16: ("R/W#", "GND"),
    17: ("E/RD#", "GND"), 18: ("D0/SCL", "SCL"), 19: ("D1/SDA", "SDA"),
    20: ("D2/SDA", "SDA"), 21: ("D3", "GND"), 22: ("D4", "GND"),
    23: ("D5", "GND"), 24: ("D6", "GND"), 25: ("D7", "GND"),
    26: ("IREF", "IREF"), 27: ("VCOMH", "VCOMH"), 28: ("VCC", "VCC_OLED"),
    29: ("VLSS", "GND"), 30: ("NC/GND", "GND"),
}


def _oled_pad(pin):
    return str(31 - pin if OLED_PIN_REVERSED else pin)


# The panel's contacts are on its viewing side. Wrapped round the bottom edge,
# they face away from the board, so J2 has to be a top-contact connector.
J2 = Part("J2", "AFC07-S30ECC-00", "lumi:JUSHUO_AFC07-S30ECC-00",
          {**{_oled_pad(p): n for p, (_, n) in OLED.items()}, "MP": "GND"},
          {**{_oled_pad(p): nm for p, (nm, _) in OLED.items()}, "MP": "MP"},
          lcsc="C11095", block="Screen",
          note="30-pin 0.5 mm top-contact ZIF for the plug-in OLED (ER-OLED0.96-1.3).")

# ---------------------------------------------------------------- passives
PASSIVES = [
    # USB-C: 5.1k on each CC pin so a USB-C charger supplies 5 V.
    R("R1", "5.1k", "CC1", "GND", "USB"),
    R("R2", "5.1k", "CC2", "GND", "USB"),
    # Charger
    C("C1", "1uF", "VBUS", "GND", "Power", note="Charger input"),
    C("C2", "1uF", "VBAT", "GND", "Power", note="Charger output / battery"),
    R("R3", "4.7k", "PROG", "GND", "Power", note="Charge current = 1000 V / R = 213 mA (0.4 C for 500 mAh)"),
    # LDO
    C("C3", "1uF", "VBAT", "GND", "Power", note="LDO input"),
    C("C4", "1uF", "3V3", "GND", "Power", note="LDO output"),
    # Module supply and strapping
    C("C5", "10uF", "3V3", "GND", "MCU"),
    C("C6", "100nF", "3V3", "GND", "MCU"),
    R("R11", "10k", "3V3", "EN", "MCU", note="EN pull-up"),
    C("C8", "1uF", "EN", "GND", "MCU", note="EN delay (with R11)"),
    R("R12", "10k", "3V3", "IO2", "MCU", note="GPIO2 strap: high"),
    R("R13", "10k", "3V3", "IO8", "MCU", note="GPIO8 strap: high"),
    # Sensing
    R("R5", "1M", "VBAT", "VBAT_SENSE", "Sense", note="Battery divider top"),
    R("R6", "1M", "VBAT_SENSE", "GND", "Sense", note="Battery divider bottom"),
    C("C9", "100nF", "VBAT_SENSE", "GND", "Sense"),
    R("R7", "100k", "VBUS", "USB_SENSE", "Sense", note="USB sense divider top"),
    R("R8", "150k", "USB_SENSE", "GND", "Sense",
      note="USB sense divider bottom: 3.0 V from 5 V, clear of the C3's 2.48 V input-high level"),
    # I2C
    R("R9", "4.7k", "3V3", "SDA", "Motion", note="I2C pull-up"),
    R("R10", "4.7k", "3V3", "SCL", "Motion", note="I2C pull-up"),
    C("C7", "100nF", "3V3", "GND", "Motion", note="LIS2DH12 decoupling"),
    # Screen: SSD1306 internal charge pump and references
    C("C10", "1uF", "C1P", "C1N", "Screen", note="Charge-pump flying cap 1"),
    C("C11", "1uF", "C2P", "C2N", "Screen", note="Charge-pump flying cap 2"),
    C("C12", "2.2uF", "VCC_OLED", "GND", "Screen", fp=C0603, note="VCC (~7.5 V): 0603, 25 V"),
    C("C13", "4.7uF", "VCOMH", "GND", "Screen", fp=C0603, note="VCOMH: 0603, 16 V+"),
    C("C14", "1uF", "3V3", "GND", "Screen", note="Panel VDD"),
    C("C15", "1uF", "VBAT", "GND", "Screen", note="Panel VBAT (charge pump)"),
    R("R15", "390k", "IREF", "GND", "Screen", note="IREF ~12 uA"),
]

# Front-side test pads, outside the screen glass.
TEST_PADS = [
    ("TP1", "3V3"), ("TP2", "GND"), ("TP3", "EN"), ("TP4", "BOOT"),
    ("TP5", "TXD"), ("TP6", "RXD"), ("TP7", "VBAT"),
]
TESTPOINTS = [Part(r, n, TP, {"1": n}, {"1": n}, block="Test", bom=False,
                   note="Hold BOOT to GND while resetting to force download mode."
                   if n == "BOOT" else "")
              for r, n in TEST_PADS]

PARTS = [U1, U2, U3, U4, D1, J1, J2, SW1, BT1, BT2, *PASSIVES, *TESTPOINTS]

POWER_NETS = {"GND", "3V3", "VBAT", "VBUS"}


def nets():
    """net name -> list of (ref, pad)."""
    out = {}
    for p in PARTS:
        for pad, net in p.pins.items():
            if net:
                out.setdefault(net, []).append((p.ref, pad))
    return out


def check():
    refs = [p.ref for p in PARTS]
    assert len(refs) == len(set(refs)), "duplicate reference"
    for net, conns in nets().items():
        assert len(conns) >= 2, f"net {net} has only one connection: {conns}"


check()
