belivablelevi/Lumi/(commit log)

2026-10-25 Add Lumi: open-source DIY robot keychain pet
    Firmware (ESP32-C3 / XIAO), portable core library (face engine, 66
    animations, gesture detection, mood, Boop Battle over ESP-NOW, app
    state machine), desktop tests and simulator, BOM, wiring, assembly
    guide, and a parametric 35x37 mm OpenSCAD case with STLs.
    Claude-Session: https://claude.ai/code/session_01XUVNECfTewFRAKhgmUk7bj
    [lumi_back.stl, lumi_case.scad, lumi_front.stl]
2026-10-26 Replace Boop Battle with Boop Pong, a two-screen ping-pong game
    The ball drops onto your screen from the top; pat while it's on the
    hit line to send it back to your pal's Lumi. Centred hits smash, tilt
    aims the return, early or late pats lose the point, first to 5 wins.
    Only the Lumi holding the ball judges the hit, balls crossing the net
    carry sequence numbers and miss counters only grow, so lost ESP-NOW
    packets just add delay. Tests play full matches and 90 s rallies over
    a 40%-loss link; the simulator tour, previews and docs show the game.
    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
    [imu.h, main.cpp]
2026-10-26 Make Boop Pong classic Pong: tilt steers the paddle
    Tilting Lumi now slides a paddle along the bottom of the screen, like
    the knob on the original Pong. The ball bounces off the paddle if it's
    underneath, and where it hits sets the return angle. Patting as the
    ball meets the paddle is an optional smash and never loses a point.
    Removes the pat-timing hit line and the animations only it used.
    Tests cover tracking, dodging and edge-hit angles, plus a full match
    steered by tilt through the real menus and gesture detector.
    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
2026-10-27 Add ESP32-S3 SuperMini as an alternative controller
    Firmware picks S3 pins automatically (GPIO5/6 I2C, GPIO4 IMU wake via
    EXT1, GPIO1 battery) and gains an esp32s3_supermini PlatformIO env.
    The case gets a board option: "s3" for SuperMinis with a built-in
    charger, "s3_tp4056" adding a charger-board layer and a second USB-C
    opening, with ready-made STLs for each. Wiring, BOM and README cover
    both power options.
    Also trims the case lip to 0.75 mm: at 0.9 mm it left 30.1 mm inside,
    narrower than the battery allowance.
    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
    [lumi_back.stl, lumi_back_s3.stl, lumi_back_s3_tp4056.stl, lumi_case.scad, lumi_front.stl, lumi_front_s3.stl, lumi_front_s3_tp4056.stl]
2026-10-29 Lumi web store: Next.js site with real firmware animations
    Pastel pre-order storefront in web/: homepage, shop, Pocket and Desk
    category pages, product page with gallery and expression viewer,
    launches, policies (placeholders), cart drawer, Stripe Checkout with
    server-side pricing and capacity reservations, an idempotent webhook,
    double opt-in launch signups, and a Supabase schema.
    Screens play frames exported from the firmware's own renderer
    (tools/studio/export_web_assets.py); product images are renders of the
    real case STLs. Unconfirmed facts (price, terms, battery life) are typed
    placeholders the catalogue refuses to sell without.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
2026-10-29 Web store: social image, spacing pass, CI job and setup guide
    Adds an Open Graph image, tightens homepage section spacing and enlarges
    the hero on phones, serves WebP only (much faster to encode than AVIF),
    and documents the Stripe, Supabase, Resend and Vercel setup in
    web/README.md. CI gains a web job: lint, typecheck, unit tests, both
    builds and the Playwright suites.
    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
2026-10-29 Renders: show the USB-C side from the right angle
    The side render faced the wrong way: it showed the face squeezed on one
    edge and no port. It now looks at the +X side with the opening, and the
    XIAO's USB-C socket is modelled inside it.
    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
2026-10-29 Web store: allow the demo on production with a second opt-in
    LUMI_DEMO_ON_PRODUCTION=1 lets the clearly marked demo catalogue run on
    Vercel's main deployment, so there's one shareable demo link. A live
    Stripe key always switches the demo off, so a demo price can never be
    charged. README walks through the deploy from main.
    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
2026-10-29 Web store: work with Vercel's Supabase, Stripe and Resend integrations
    Accepts NEXT_PUBLIC_SUPABASE_URL as well as SUPABASE_URL, and the README
    lists which integration fills which variable and the one-time steps they
    don't do (database setup, capacity, Stripe webhook, CASL details).
    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
2026-10-29 Hardware: plan for a factory-assembled Lumi PCB
    Parts, layout sketch, pin map, firmware and case changes, build steps,
    prototype budget and certification notes for one integrated board
    (ESP32-C3-MINI-1 module, LIS2DH12/SC7A20 accelerometer, bare SSD1306
    panel, TP4054 charger) aimed at the lowest cost per unit.
    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
2026-10-29 PCB plan: record case, power switch and sensor decisions
    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
2026-10-29 Firmware: support the LIS2DH12 accelerometer for the Lumi PCB
    imu.cpp now finds whichever accelerometer is fitted: an MPU-6050/6500
    (GY-521) or a LIS2DH12 (the planned PCB, or a breakout), with the same
    100 Hz FIFO reads, units and wake-on-motion. A desktop test drives the
    driver against register models of both chips (tests/imu). Also adds the
    draft PCB parts list with LCSC numbers, wiring for trying a LIS2DH12
    breakout on today's build, and moves the power switch to the LDO enable
    pin so it never carries radio current.
    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
2026-10-29 PCB parts list: pick a plug-in OLED panel
    BuyDisplay ER-OLED0.96-1: bare SSD1306 128x64 with a plug-in 30-pin
    0.5 mm FPC, so the factory only places a ZIF connector and the screen
    snaps in at assembly. Notes the expected I2C wiring and capacitors, to be
    checked against the panel's datasheet.
    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
2026-10-30 Website Boop Pong: calmer steering
    The paddle goes wherever the input points, so small movements threw it
    across the court. Phone tilt now needs 40 degrees (was 25) to reach the
    edge, with a 3 degree dead zone; arrow keys move at half speed; and every
    input is smoothed (120 ms) so a flick of the mouse or phone glides
    instead of snapping. The firmware's own steering is unchanged.
    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
2026-10-30 Case modelling in Blender: PCB references, fit check, Mini Lumi 2 case
    hardware/enclosure/blender/ prepares Blender (4.2+, tested on 5.0) for
    modelling a case around the Lumi PCB:
    - lumi_refs.py sets the scene to millimetres and loads the board, every
    part at its real height, the screen glass and cable, the battery, the
    USB-C and switch openings and the antenna keep-out, all under one
    movable handle, plus an empty Case collection to model in.
    - check_fit.py reports parts that hit the case and openings it blocks.
    - lumi_pcb_v1_refs.json/.obj are generated from the KiCad board by
    hardware/pcb/kicad/case_refs.py (the OBJ works without scripts).
    hardware/enclosure/alternatives/mini_lumi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
    [lumi_pcb_v1_refs.obj, mini_lumi2.stl]
2026-10-30 PCB v1 draft: KiCad schematic, routed board, JLCPCB files and guide
    Everything is generated from hardware/pcb/kicad/design.py (parts and
    connections) by build.sh: gen_schematic.py draws the schematic,
    gen_board.py places the parts (all on the back, 31 x 33 mm, 2 layers),
    route.py autoroutes with Freerouting 2.1 and adds ground pours and
    stitching vias, check.py compares the schematic netlist and the board pad
    by pad against design.py and runs KiCad's DRC (0 violations, nothing
    unrouted), and fab.py writes the Gerbers, the BOM and CPL in JLCPCB's
    format, a STEP model and the case height stack. case_refs.py exports the
    Blender case references.
    DRAFT, not reviewed: the OLED panel, TP4054, RT90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
    [lumi-bom.csv, lumi.kicad_pcb, lumi.kicad_sch, lumi.step, lumi_pcb_v1_refs.obj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]
2026-10-30 Mini Lumi case for the PCB, built by a Blender script
    hardware/enclosure/blender/mini_lumi_case.py builds the Mini Lumi desk
    case around the PCB reference sizes: chin with a raised Lumi badge,
    bezel leaning back 6 degrees with a stepped window centred on the
    screen's active area, USB-C opening with a plug recess in the left side,
    switch slot and finger pocket in the right, ledges and posts that hold
    the board, a battery bay, and a vented lid on a 1.5 mm lip joint.
    It's 36.4 x 26.9 x 40.8 mm (the original was 35 x 41 x 40.5) and checks
    itself: both parts closed solids, and check_fit.py finding nothing that
    touches the case and no blocked opening. Print-ready STLs, the assembled
    .blend and pr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
    [mini_lumi_pcb.blend, mini_lumi_pcb_body.stl, mini_lumi_pcb_lid.stl]
2026-10-30 PCB budget: 5 and 10 prototypes, per unit at 100 and 1,000, USD and CAD
    hardware/pcb/budget.py holds the price table (checked 2026-10-30; lines
    without a live quote are marked as estimates) and writes BUDGET.md and
    budget.csv: board parts by quantity, JLCPCB fabrication and Economic
    assembly fees, screens, batteries, the printed case, shipping to Canada,
    GST and courier brokerage, at 1 USD = 1.40 CAD.
    5 prototypes all in come to about $189 USD ($264 CAD), 10 to $269
    ($376); one Lumi costs about $11.70 at 100 units and $8.00 at 1,000.
    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
    [budget.csv]
2026-10-30 Budget as an Excel workbook with live formulas
    budget.py now also writes hardware/pcb/budget.xlsx: Summary, Inputs,
    Parts, Prototypes, Per unit and Sources tabs. Every price, fee, quantity,
    the exchange rate and GST are blue input cells, and all totals are
    formulas, so editing an input in Excel updates the budget. Recalculated
    with LibreOffice: 119 formulas, no errors, totals match BUDGET.md.
    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
    [budget.xlsx]
2026-10-30 Personality-odds insert card, and both Mini Lumi cases in the shop gallery
    - tools/studio: lumi_studio/odds_card.py draws a 4 x 6 in two-sided card from the
    firmware's gene weights and face engine (rarity 60/25/12/3, temperaments, eye
    shapes, highlights, accents). Writes a print-shop PDF with bleed and a Letter
    2-up PDF with cut marks. Studio: Factory batch -> Export odds card. Brand fonts
    (OFL) bundled as static weights so the PDF embeds them.
    - docs/print: the PDFs, previews and printing instructions.
    - web: render-case renders the Mini Lumi PCB case and Mini Lumi 2 from their STLs;
    five new gallery images with captions. Existing renders are unchanged.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
2026-10-31 Lumi PCB: rebuild in KiCad 10 with datasheet fixes
    Checking the draft against the panel and Espressif datasheets found faults
    the design-rule check can't see: a mirrored panel at J2, a bottom-contact
    connector where the panel needs top contact, a screen cable that couldn't
    reach, VBAT below the panel's range, marginal USB sense, and copper under
    the antenna. All are fixed and the board is rebuilt with 0 DRC violations.
    Not ordered or tested on hardware. GUIDE.md lists what's still to check,
    including J2's own PDF, the real cable fit and the battery behind the antenna.
    Claude-Session: https://claude.ai/code/session_01NGZp68ebE8nq2zT4H5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
    [lumi-bom.csv, lumi.kicad_pcb, lumi.kicad_sch, lumi.step, lumi_pcb_v1_refs.obj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]
2026-10-31 Cases: centre the keyring tab on top
    The OG tab and hole are now centred on the case, front to back, and the
    Mini Lumi PCB case gains a centred tab. The OG front STLs were built in
    Blender and match a fresh OpenSCAD build of lumi_case.scad to within
    0.009 mm. The tab stands clear of the bed, so it needs support when printed.
    None of these have been test-printed.
    Claude-Session: https://claude.ai/code/session_01NGZp68ebE8nq2zT4H5x4dy
    [lumi_case.scad, lumi_front.stl, lumi_front_s3.stl, lumi_front_s3_tp4056.stl, mini_lumi_pcb.blend, mini_lumi_pcb_body.stl, mini_lumi_pcb_lid.stl]
2026-10-31 Site: path-traced product renders from Blender
    All 12 product images are re-rendered at 2000 px with Cycles from the real
    case STLs, showing the centred tabs, replacing the three.js renderer and its
    dependency. The README now names Snaggo as the site.
    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
2026-11-03 Cases: snap fit, and a deeper OG case with room for the parts
    OG Pocket Lumi case (lumi_case.scad):
    - 23.5 mm deep instead of 19.5 (30.2 mm with a separate TP4056 charger
    board), so the solder joints, wires and battery leads have room.
    - Four snap hooks on the front half click into grooves in the back, with a
    fingernail notch at the seam for opening. No glue or screws.
    - Seats for the XIAO (with a stop that takes the USB plug's push) and the
    motion sensor, and crush ribs that stop the battery rattling.
    - The lip now joins the wall through a 45-degree shelf. Before, it floated
    and wouldn't print.
    - Corners 6 mm instead of 7, so a square battery clears them.
    - A fit check (part="fit_ch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
    [lumi_back.stl, lumi_back_s3.stl, lumi_back_s3_tp4056.stl, lumi_case.scad, lumi_front.stl, lumi_front_s3.stl, lumi_front_s3_tp4056.stl, lumi_pcb_v1_refs.obj]
2026-11-03 Site: fix the white-on-white Notify me button on dark backgrounds
    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
2026-11-04 Case: 0.45 mm snap catch, 702025 battery, tapered snap arms
    - Tapered snap arms with a root fillet, to spread the bending strain
    - snap_catch 0.45 from the PLA snap test (stl/snap_test.stl)
    - Battery space for the 702025 cell (300 mAh): case now 25.5 mm deep
    - Keyring tab stays wholly in the front part at the new depth
    - Rebuilt all six parts; all three fit checks are empty
    - Filament: ELEGOO PETG black/grey, print settings, no carbon fibre
    - Docs, BOM and product page updated for the new battery and depth
    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
    [lumi_back.stl, lumi_back_s3.stl, lumi_back_s3_tp4056.stl, lumi_case.scad, lumi_front.stl, lumi_front_s3.stl, lumi_front_s3_tp4056.stl, snap_test.stl]
2026-11-04 Shipping mode: Lumi sleeps in the post and wakes for three taps
    - New ShipLock (lumi_core): after a motion wake, listens for pats with the
    screen off; a freefall, shake or orientation change restarts the count
    - `ship` serial command and a NVS flag (HAL shipModeGet/Set); Lumi Studio
    gets a "Ship mode" button that reports the battery level
    - main.cpp: ship-mode boots stay dark and go back to sleep unless tapped;
    firmer wake threshold while shipping; no accelerometer leaves ship mode
    - Desktop tests for the lock and the command; assembly guide packing step
    - Case: optional screen pins through the OLED's corner holes (off until
    the holes are measured), with a part="screen_test" plate
    C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
    [lumi_case.scad]
2026-11-04 Order admin, own checkout page with live shipping, protection and tips
    - /admin behind ADMIN_PASSWORD: orders to ship, CSV export (Chit Chats
    columns), unit names and notes, mark shipped with tracking + email,
    refunds from Stripe's charge.refunded webhook return unsold units
    - /checkout: Stripe Elements with Checkout Sessions. The server sets the
    shipping address and prices it (Canada Post Rating API, region table as
    backup); shipping protection ($3.98) and dollar tips as line items
    - Webhook checks products + tip + protection and that shipping was priced
    - Migration 0003_fulfilment.sql: fulfilment, refunds and checkout extras
    - Unit, SQL and browser tests; README and .env.example up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
2026-11-04 Shipping text, birth-certificate cards, third board in CI
    - Product page, Shipping and Returns and FAQ: ships to Canada and the US
    with Canada Post, priced from the address at checkout, protection, and
    how to wake Lumi (tap three times). Canada + US is now the default.
    - PolicyPage: sections can carry real text; unwritten ones stay marked
    - Lumi Studio: printable birth certificates per unit (business-card size,
    8 per Letter sheet, both sides, cut marks) from "Export cards..."
    - CI builds the ESP32-C3 SuperMini firmware too
    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
2026-11-04 Renders for the 25.5 mm case, birth-certificate design, full unit cost
    - Product renders re-made from the current case STLs (25.5 mm deep)
    - Birth certificates: the unit's face at its true shape inside a drawing
    of the real case, its odds (1/N) in its rarity's colour, a settings
    note on the back; unhinted fonts fix letter spacing on Windows (odds
    card too)
    - Budget: full average unit cost (packaging, spares, Stripe fee,
    prototype run, certification and tools inputs) in BUDGET.md, the CSV
    and a new "Full unit cost" tab; files are written as UTF-8
    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
    [budget.csv, budget.xlsx]
2026-11-04 Checkout: Pay button no longer waits for an email Stripe didn't have
    canConfirm stays false until the session has an email, and the page only
    sent it on confirm, so the button never enabled. Send the email to the
    session when the field is left and before confirming, and gate the button
    on the address and shipping only; confirm reports anything else missing.
    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
2026-11-04 Checkout: unmount the address form before paying, and stop the endless spinner
    With update_shipping_details set to server_only, Stripe refuses confirm()
    while the ShippingAddressElement is mounted. It was only hidden, so Pay hung.
    The form now unmounts after "Use this address". Pay sends the email once,
    then confirms, with timeouts and a visible error instead of spinning forever.
    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
2026-11-05 Shipped email names, canonical tags, IndexNow, C3 SuperMini case
    - Admin: optional "Name it in the email" checkbox; shipped email says
    "Starla is on their way!" (names only, no serials). Logo in email header.
    - Canonical URLs on every public page; IndexNow key and submit script.
    - Print docs: birth-certificate cards.
    - PCB budget: live JLCPCB prices, LIS2DH12 stock warning.
    - Case: board="c3_tp4056" (ESP32-C3 SuperMini + TP4056); wiring adds the
    C3 SuperMini, a backfeed diode and the TP4056 charge-current resistor.
    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
    [budget.csv, budget.xlsx, lumi_case.scad]
2026-11-05 Renders: 3D-printed look, PETG grey/black and milky green
    - Shell shader now looks FDM printed: 0.2 mm layer lines along each part's
    print direction, glossier bed faces with first-layer lines, darker grooves.
    - New shots in the real ELEGOO PETG grey and black, and a milky green
    limited edition; PLA, PETG and milky finishes per shot.
    - renders.json always lists every shot, so --only can render new ones.
    - All product images re-rendered.
    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
2026-11-05 Canada Post test: tell a 403 apart
    The live test got 403 with an empty body for every price after the token
    worked. The test now also asks for a regular (counter) price without the
    customer number, which shows whether the number doesn't match the API key's
    account, and an empty refusal shows Canada Post's trace headers. Requests
    carry a Snaggo User-Agent.
    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
2026-11-05 Studio in Chrome, step 1: build the face engine to WebAssembly in CI
    The Chrome version of Lumi Studio runs the firmware's own face engine
    (lumi_core through the desktop app's C API), compiled with wasi-sdk like
    the website's Boop Pong. CI builds it and checks the committed
    web/public/studio/lumicore.wasm is current, and the desktop tests write
    tests/golden/studio_parity.json, the desktop's packs, batch and odds
    for fixed inputs, that the web port is tested against.
2026-11-05 Studio in Chrome, step 2: the face engine, packs and batches in TypeScript
    - web/public/studio/lumicore.wasm: the firmware's lumi_core, built by CI.
    - web/src/lib/studio/core.ts: the engine's API for the browser, like the
    desktop's native.py (rendering, genes, odds, pack checks, the animator).
    - model.ts and factory.ts: ports of the desktop's model.py and
    factory.py (faces, .lumiproject files, emotion packs, default_pack.h,
    batches and manifest CSVs).
    - Tests: every expression matches the firmware's golden frames, and packs,
    a 50-unit batch, quotas, odds and automatic personas match the desktop
    app byte for byte (tests/golden/studio_parity.json).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
2026-11-05 Studio in Chrome, step 3: the Studio page and print views
    www.snaggo.tech/admin/studio (behind the admin login): the Faces,
    Animations, Personality and Factory batch tabs of Lumi Studio, drawn by
    the firmware's face engine in WebAssembly, so it works on a Chromebook
    with nothing to install.
    - Same files as the desktop app: .lumiproject, .lumipack, default_pack.h
    and manifest CSVs, with Chrome's Open and Save dialogs (downloads
    elsewhere). Work in progress is kept in the browser.
    - Birth certificates (8 per Letter, both sides, cut marks) and the odds
    card (4 x 6 in for a print shop, or 2 per Letter) as print pages that
    Chrome saves as PDF at their real size; ported from unit_cards.py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
2026-11-06 Shipping: price small boxes as Canada Post's smallest parcel
    Canada Post won't price a parcel under 23 x 20 x 2.5 cm inside Canada
    (error 9111, which the admin test showed for the 10 x 10 x 6 cm box) and
    charges a smaller one as that size anyway. Domestic quotes now round each
    side up to the minimum, and the test page says when it does.
2026-11-06 Shipping: flat prices set in Vercel, carrier-neutral wording
    Checkout's region prices now come from SHIPPING_PRICE_ON_QC,
    SHIPPING_PRICE_REST_OF_CANADA, SHIPPING_PRICE_NORTH and SHIPPING_PRICE_US
    (dollars), falling back to the old table. Flat-price quotes are labelled
    "Tracked shipping", and the shipping page, product page and llms.txt no
    longer name Canada Post, so any carrier can take the parcels. Stallion
    Express joins the carriers in the order admin.
2026-11-06 Shipping page: drop the ground-only claim
    Canada Post accepts a device with up to 4 built-in lithium cells by air
    or ground, so the battery doesn't decide how a Lumi travels.
2026-11-06 PCB v1: ESP32-C3-MINI-1 module, rounded corners, routed and checked
    - U1 is now the ESP32-C3-MINI-1-H4X module (C41349510) with its own
    footprint; SW1 uses a footprint matched to the MSK12C02 (the PCM12
    one was 0.5 mm off).
    - 4 mm rounded corners and an antenna notch, so the board fits inside
    today's case corners. Parts re-placed to suit.
    - Parts fixes from the new LCSC/JLCPCB check (verify_parts.py): R15 is
    390k C25782 (C25778 was 330k), R3 4.7k Basic. 10 Extended parts.
    - Routed with Freerouting (Java heap capped at 1.5 GB) and finished by
    hand at one VBAT stub. DRC: 0 violations, 0 unrouted; 177 pin
    connections match the schematic.
    - Factory files, renders, budget and the case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
    [budget.csv, budget.xlsx, lumi-bom.csv, lumi.kicad_pcb, lumi.kicad_sch, lumi.step, lumi_pcb_v1_refs.obj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]
2026-11-06 Admin: Make demo order button for testing labels
    A fake paid order for one Pocket Lumi to a public landmark (Toronto,
    Vancouver, Whitehorse or New York), made from the bottom of /admin. It has
    no email, no Stripe payment and no stock reservation, stays out of the CSV
    export, and its page has a Delete demo order button (blocked while a Chit
    Chats shipment is attached). Only orders whose session id is demo_<id> can
    be deleted.
2026-11-06 Admin: Delete demo order also removes its test shipment
    It used to refuse while a Chit Chats shipment was attached. Now it deletes
    the unpaid shipment in Chit Chats first (a bought label still keeps the
    order), shows any Chit Chats or database error on the page, and says so if
    nothing was deleted instead of reporting success.
2026-11-06 Free shipping only where shipping costs under $15
    SHIPPING_FREE_MAX (dollars, default 15, "none" for no limit): an order
    over SHIPPING_FREE_OVER ships free only if its shipping, packing charge
    included, would cost less than this. At the default prices the North ($15)
    still pays. The cart note, shipping page and admin summary name where it
    applies ("Canada, except the territories").
2026-11-07 Chit Chats labels follow their battery rules
    Chit Chats' compliance team confirmed how Lumi's built-in cell ships:
    - One Lumi per package: Class 9 Unmarked, padded mailer, no markings.
    - More than one: Class 9 Marked, a sturdy box of at most 5.5 lb with a
    lithium battery mark (with a phone number), US by U.S. Edge.
    - Canadian shipments follow the same packing but aren't declared.
    Labels now pick the code and package type per order, leave the code off
    Canadian shipments, refuse marked parcels over 5.5 lb, and can use a
    separate box (SHIPPING_MULTI_BOX_CM / _KG) for multi-Lumi orders. The
    order page says how to pack each one.
2026-11-07 Pocket Lumi: $35 CAD
    The retail price is set, so the product page and cards show it. It is
    still coming soon, so nothing can be bought yet. Demo orders use the
    real price.
2026-11-07 Rename Boop Pong to Tilt Pong
    Only the name changes: website, device title card and lobby, docs and
    tests. The web game's compiled title text is swapped in place (same
    length); the docs preview images still show the old card until the
    simulator is rerun.
    [animations_tab.py, imu.h]
2026-11-07 Clip maker: spin videos and face clips for TikTok and Instagram
    A new admin page, /admin/clips, draws short vertical videos and stills
    in the browser:
    - 3D spin: the real Mini Lumi PCB case (STLs in public/models) in any
    shell colour, with the firmware face playing on its screen, feature
    lines that appear one at a time (each can play an animation), and an
    end card with the price. The spin always settles facing the camera.
    - Face close-up: the big pixel face with top and bottom captions.
    - Backgrounds (shell-matched, night glow, brand colours, or a local
    photo), 9:16, 4:5 and 1:1, MP4 where the browser records it (Chrome,
    Edge), otherwise WebM, plus PNG stills.
    three.js loads only o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
    [lumi-body.stl, lumi-lid.stl]
2026-11-12 Add the Videos admin page
    /admin/videos lists the finished films for TikTok and Instagram, each
    with a player, its caption, a copy button and a download link. The
    films are in public/videos and the list in src/lib/videos.ts.
